kyberpunk/smart_socket/iot_edge_modules/azure-iot-sdk-c/c-utility/devdoc/img/tlsio_state_diagram.png

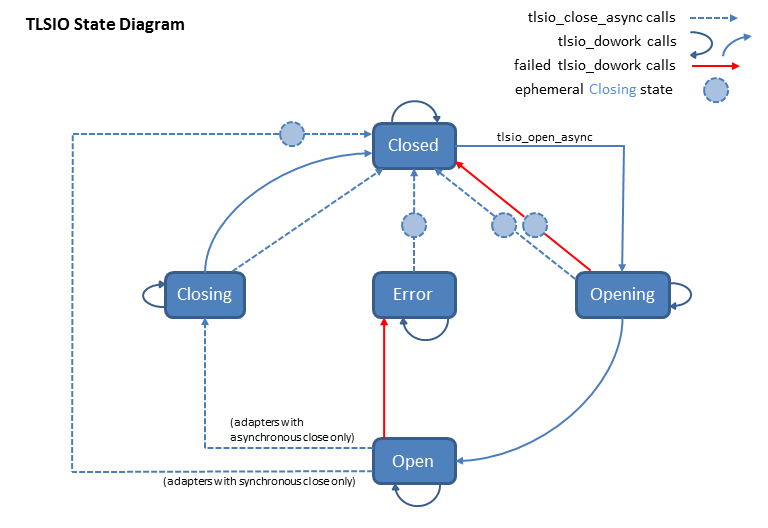
iot_edge_modules/azure-iot-sdk-c/c-utility/devdoc/img/tlsio_state_diagram.png
