kyberpunk/smart_socket/iot_edge_modules/azure-iot-sdk-c/doc/media/azure_portal/azure-portal-eventhub-constring.png

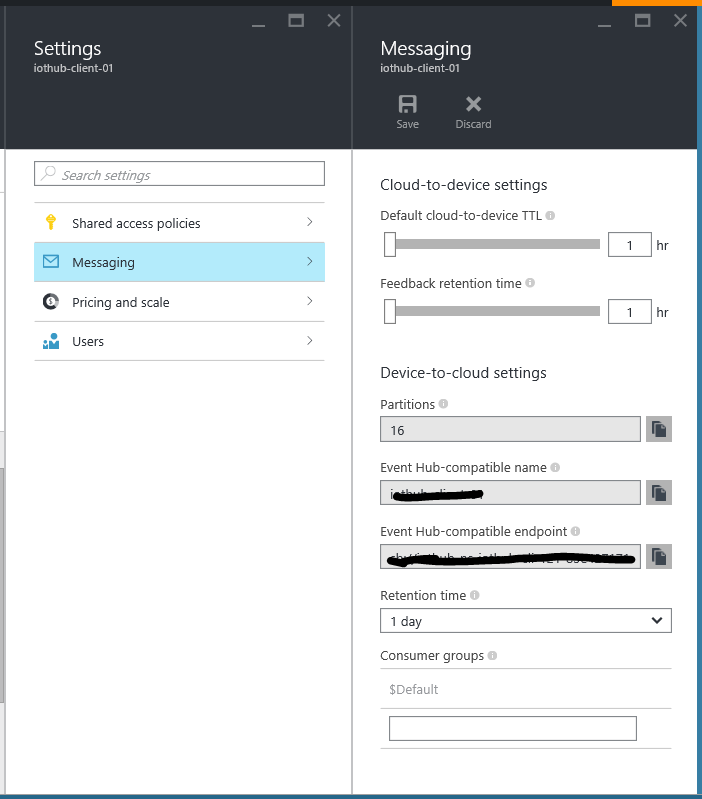
iot_edge_modules/azure-iot-sdk-c/doc/media/azure_portal/azure-portal-eventhub-constring.png
