kyberpunk/smart_socket/iot_edge_modules/azure-iot-sdk-c/doc/media/iothubclient_app_from_scratch/eclipselibraries.png

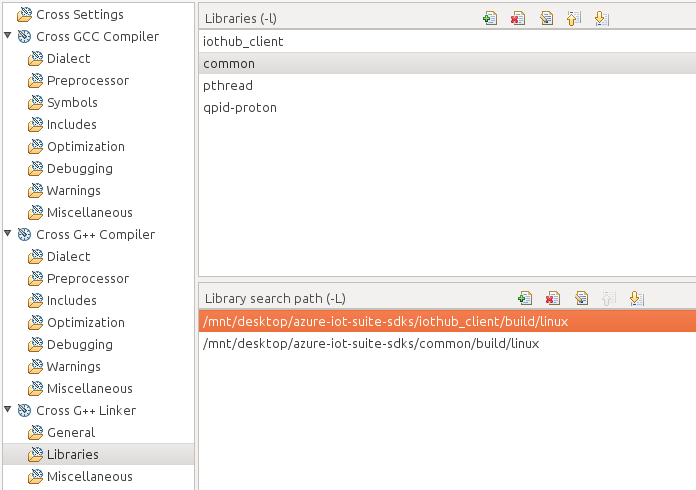
iot_edge_modules/azure-iot-sdk-c/doc/media/iothubclient_app_from_scratch/eclipselibraries.png
