kyberpunk/smart_socket/iot_edge_modules/azure-iot-sdk-c/doc/media/iothubclient_app_from_scratch/vsgenerallinkerproperties.png

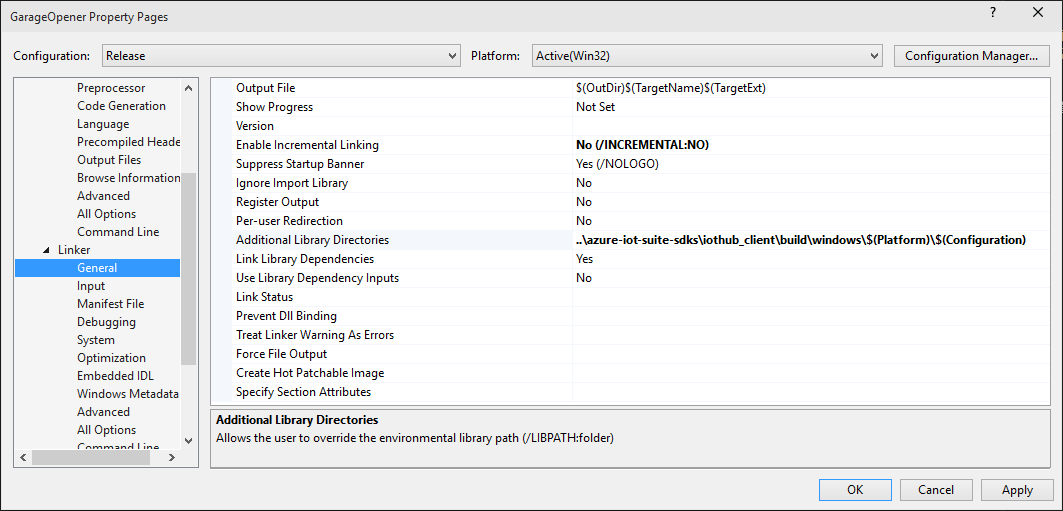
iot_edge_modules/azure-iot-sdk-c/doc/media/iothubclient_app_from_scratch/vsgenerallinkerproperties.png
