kyberpunk/smart_socket/iot_edge_modules/azure-iot-sdk-c/doc/media/tizenRT2.png

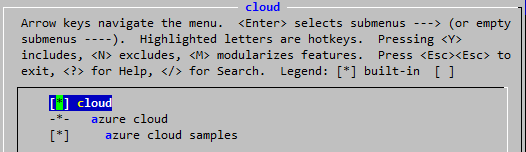
iot_edge_modules/azure-iot-sdk-c/doc/media/tizenRT2.png
