kyberpunk/smart_socket/iot_edge_modules/azure-iot-sdk-c/iothub_client/devdoc/requirement_docs/iothubhttptransport_image.jpg

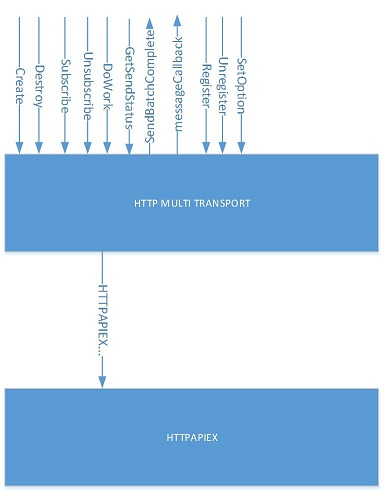
iot_edge_modules/azure-iot-sdk-c/iothub_client/devdoc/requirement_docs/iothubhttptransport_image.jpg
