kyberpunk/smart_socket/iot_edge_modules/azure-iot-sdk-c/lts_branches.png

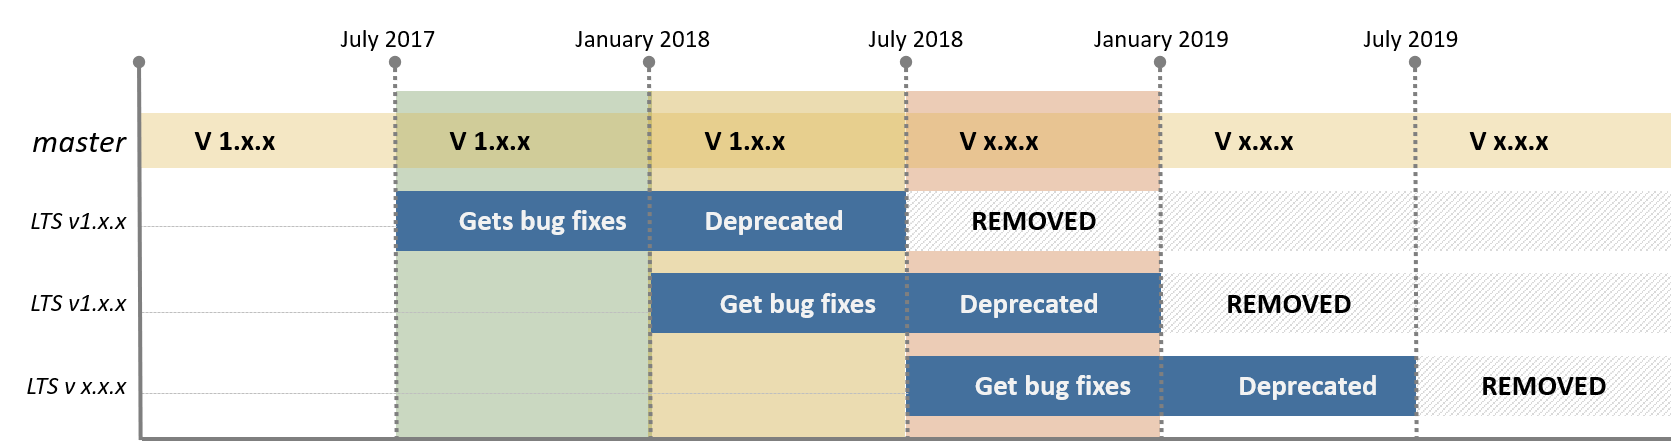
iot_edge_modules/azure-iot-sdk-c/lts_branches.png
