kyberpunk/smart_socket/iot_edge_modules/azure-iot-sdk-c/provisioning_client/devdoc/media/client_high_level_diagram.png

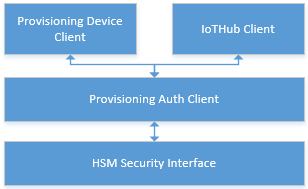
iot_edge_modules/azure-iot-sdk-c/provisioning_client/devdoc/media/client_high_level_diagram.png
