kyberpunk/smart_socket/smart_socket/openthread/doc/images/ot-contrib-qorvo.png

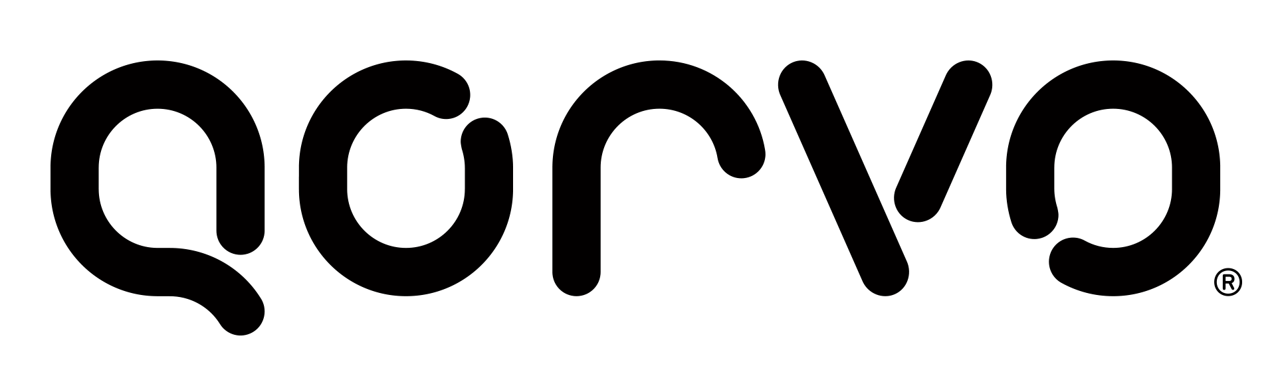
smart_socket/openthread/doc/images/ot-contrib-qorvo.png
