kyberpunk/smart_socket/smart_socket/openthread/doc/images/windows-app-details.png

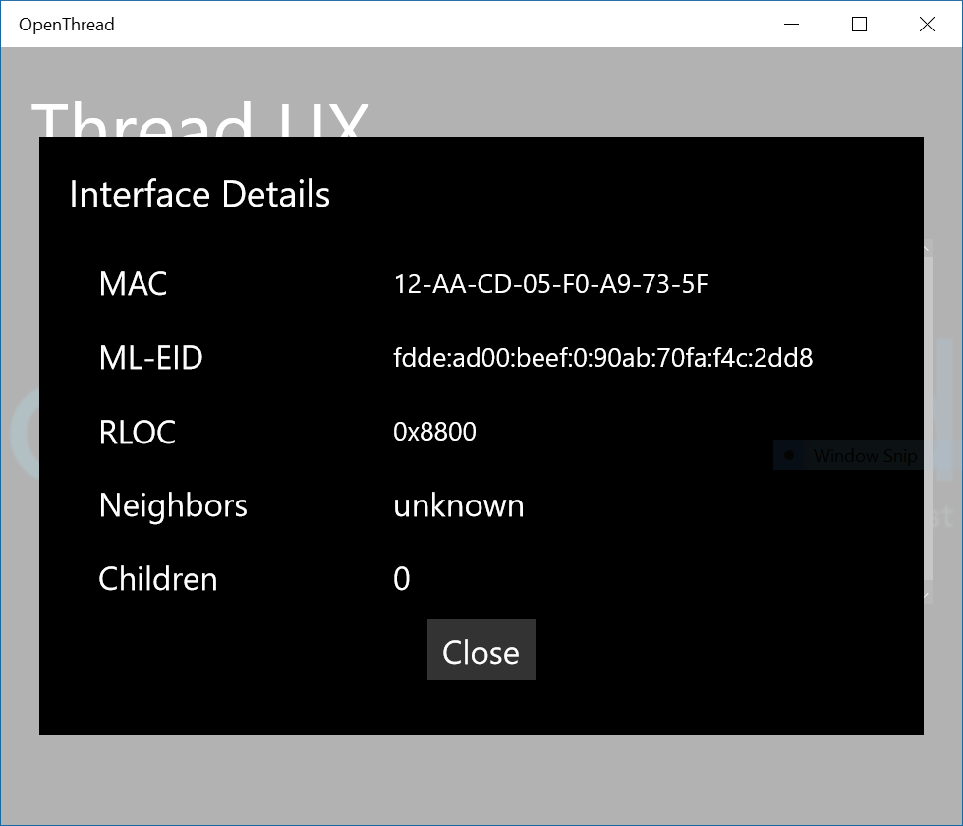
smart_socket/openthread/doc/images/windows-app-details.png
