kyberpunk/smart_socket/smart_socket/openthread/doc/images/windows-app-interface-list.png

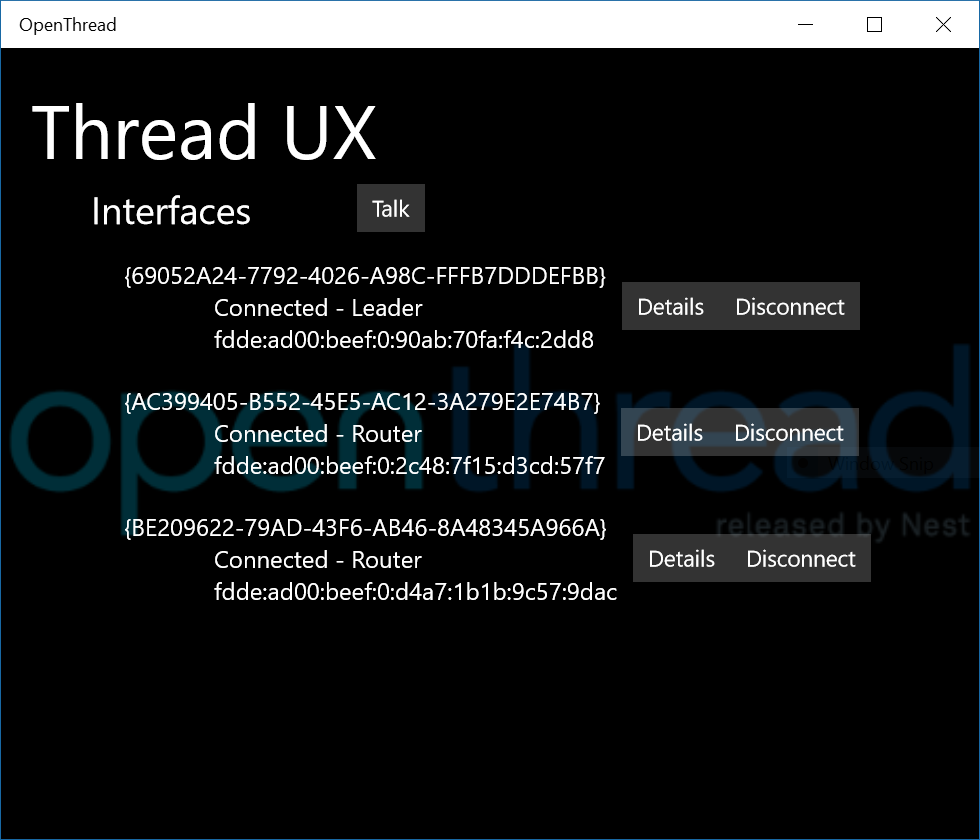
smart_socket/openthread/doc/images/windows-app-interface-list.png
