kyberpunk/smart_socket/smart_socket/openthread/doc/images/windows-app-talk-client.png

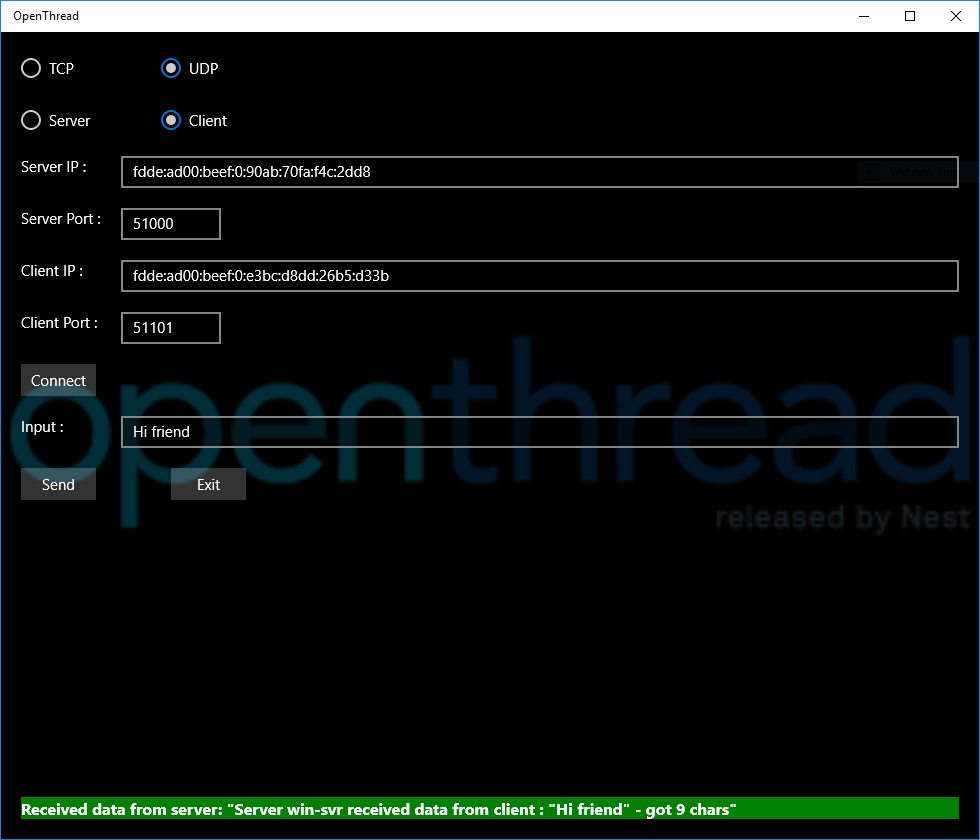
smart_socket/openthread/doc/images/windows-app-talk-client.png
