kyberpunk/smart_socket/smart_socket/openthread/doc/images/windows-app-talk-server.png

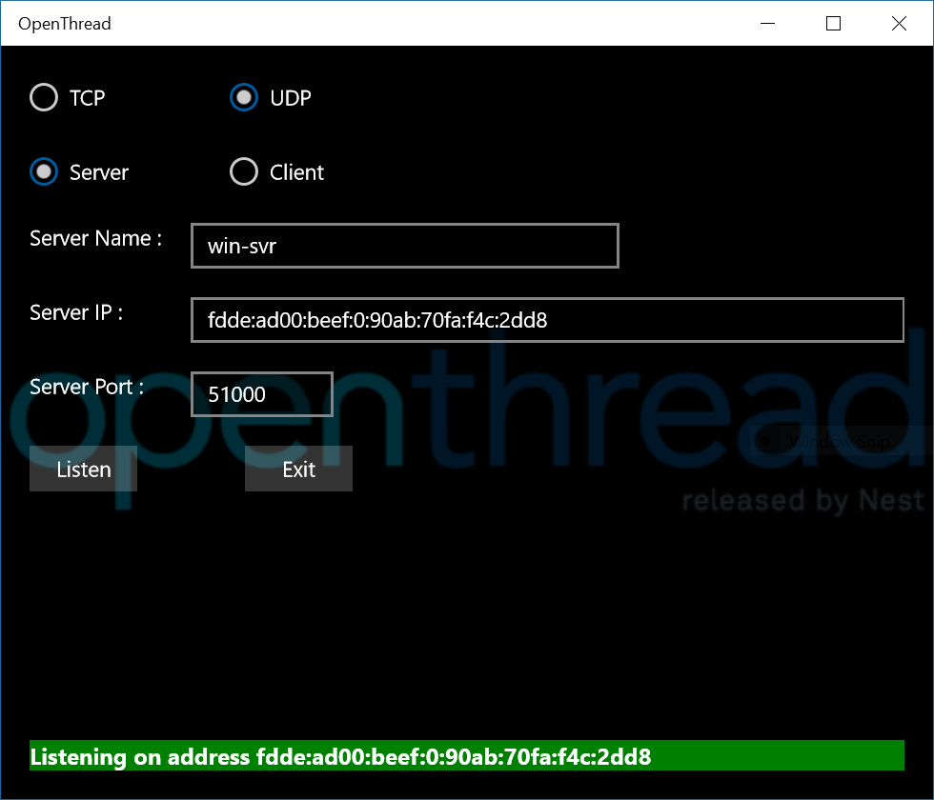
smart_socket/openthread/doc/images/windows-app-talk-server.png
