kyberpunk/smart_socket/smart_socket/openthread/doc/images/windows_design.png

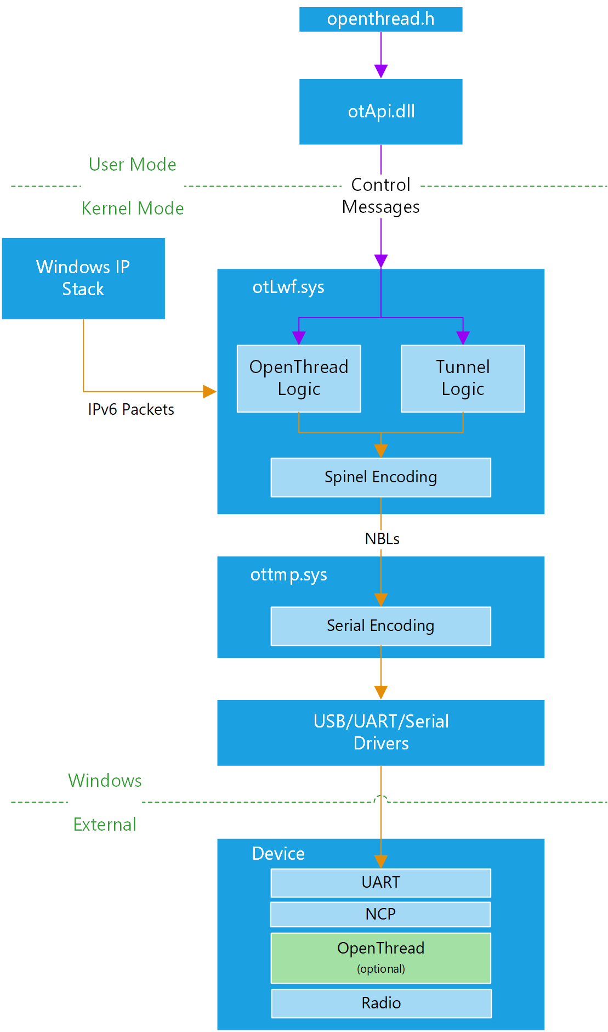
smart_socket/openthread/doc/images/windows_design.png
