kyberpunk/smart_socket/smart_socket/openthread/tools/harness-thci/OpenThread.png

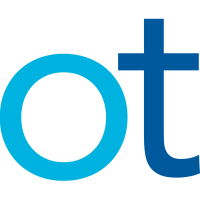
smart_socket/openthread/tools/harness-thci/OpenThread.png
