kyberpunk/smart_socket/iot_edge_modules/azure-iot-sdk-c/doc/media/service-bus-iot-raspberrypi-raspbian-setup/raspbian01.png

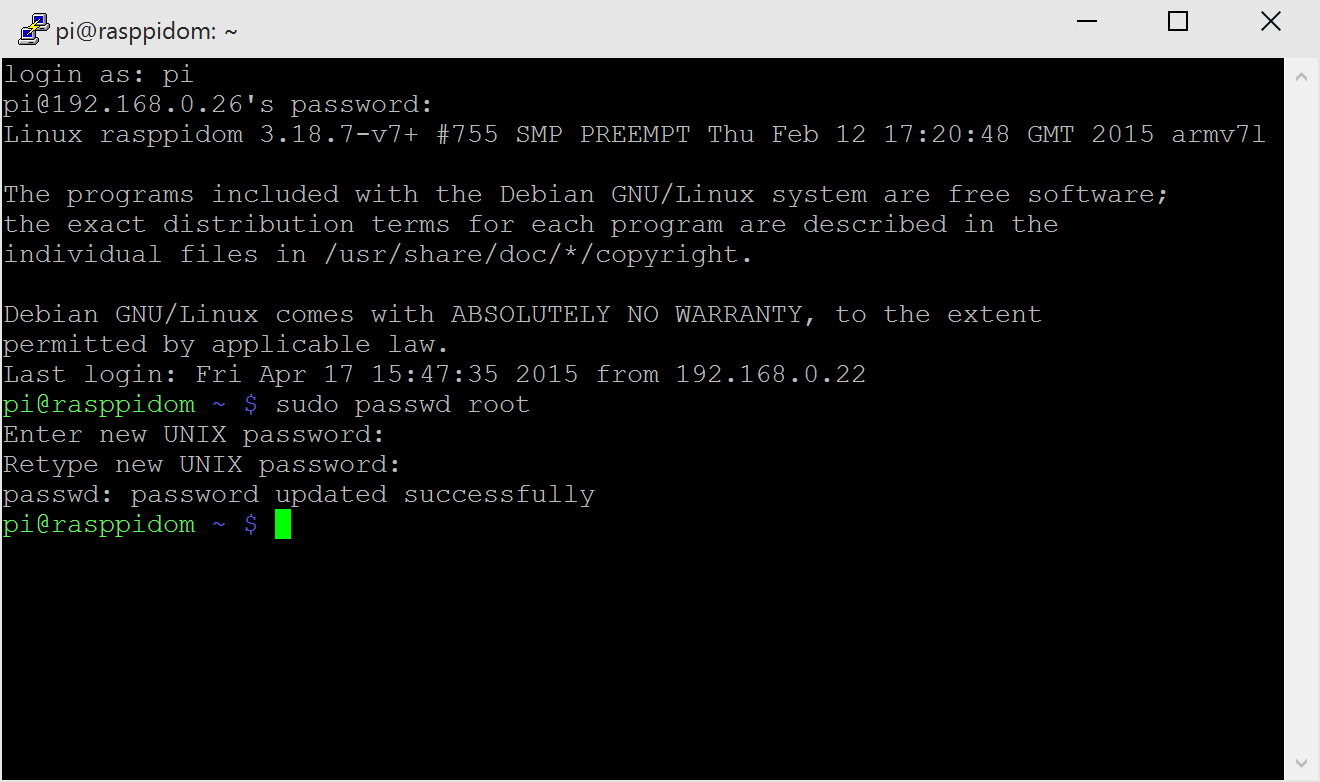
iot_edge_modules/azure-iot-sdk-c/doc/media/service-bus-iot-raspberrypi-raspbian-setup/raspbian01.png
