kyberpunk/smart_socket/docs/chip_shield_sch.pdf

10k ⁺³V3 | GND | +³V3

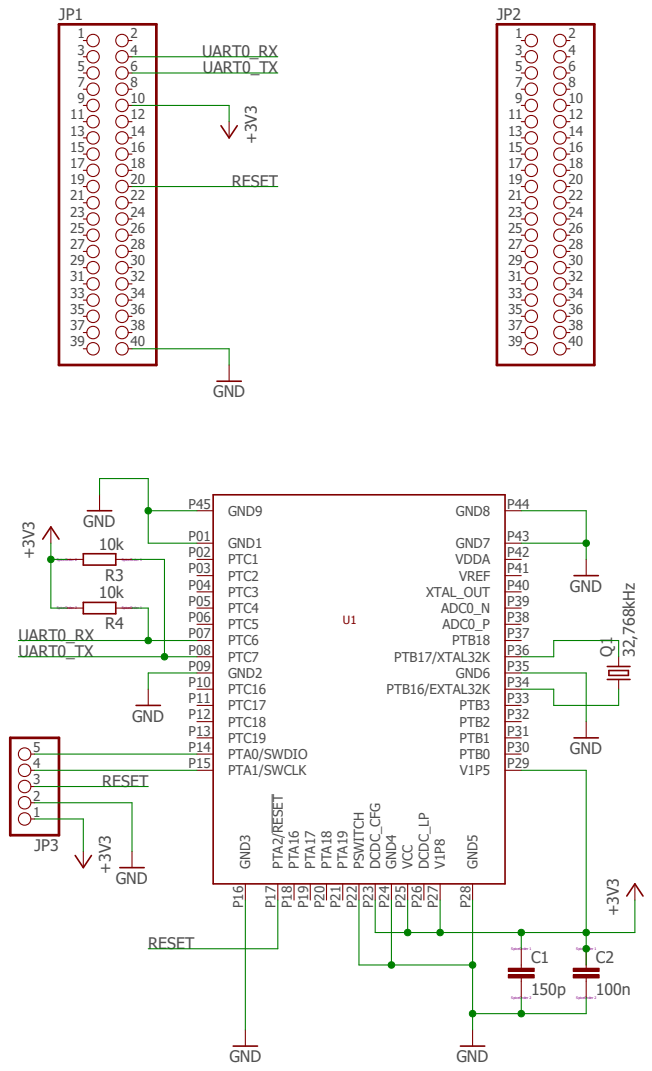
[picture p54: page 1]

Document Number: Author: Vít Holásek | REV:

Date: 16.05.2018 22:05 | Sheet: 1/1
