kyberpunk/smart_socket/docs/smart_socket_sch.pdf

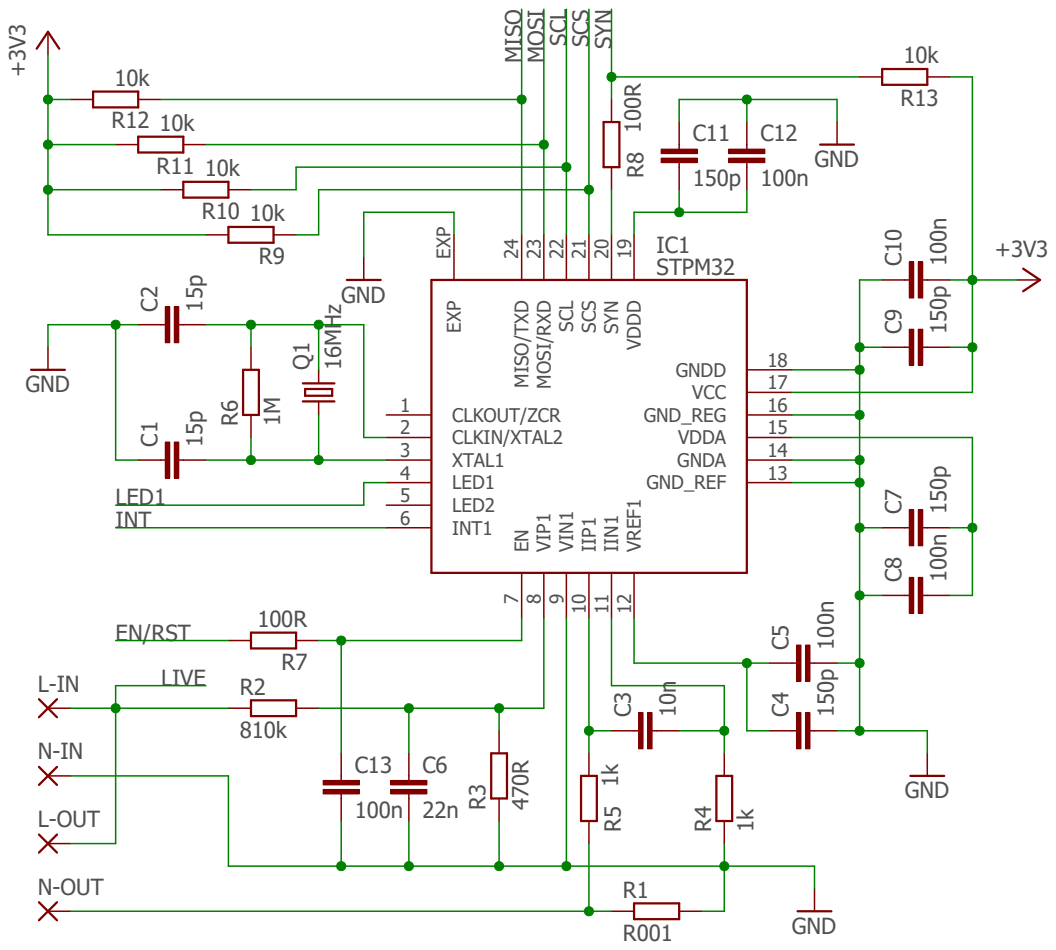
[picture p55: page 1]

Document Number: Author: Vít Holásek | REV:

Date: 14.05.2018 21:31 | Sheet: 1/2

# GND ⁺³V3 32,768kHz

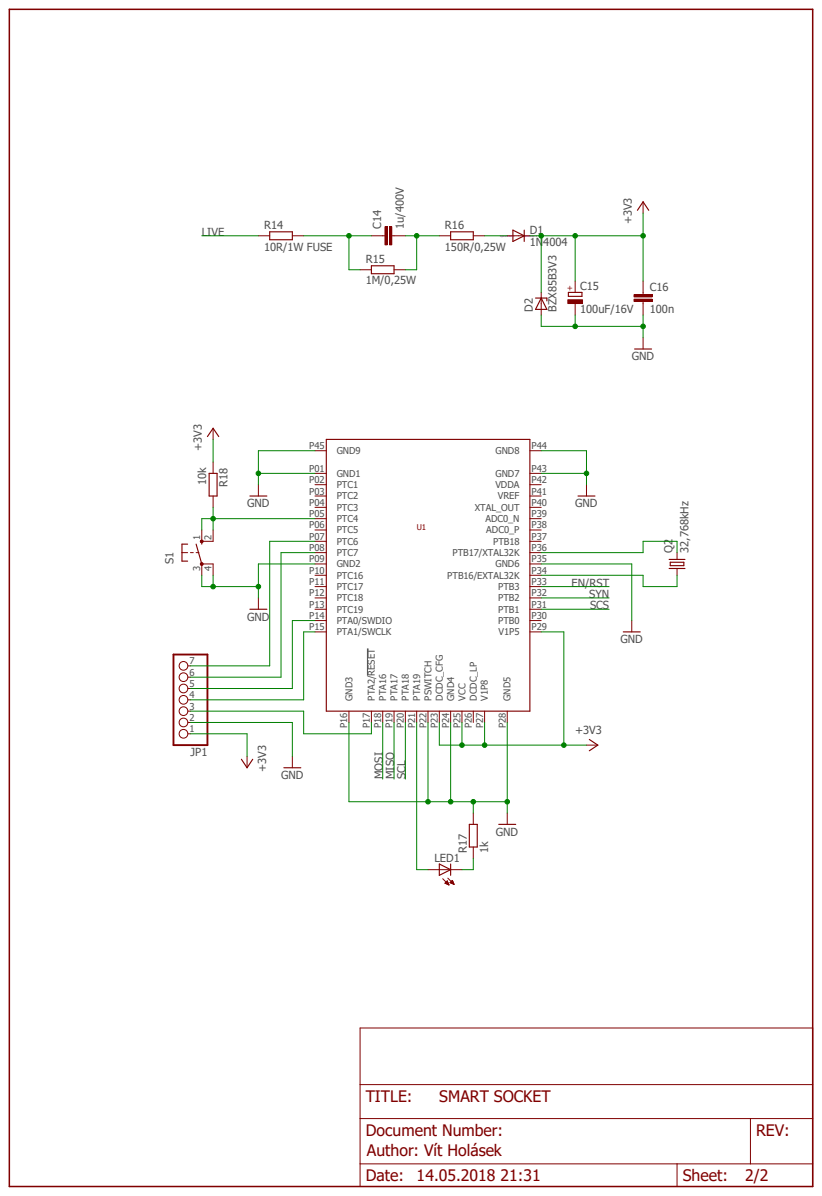
[picture p56: page 2]

SYN MOSI MISO SCL

Document Number: Author: Vít Holásek | REV:

Date: 14.05.2018 21:31 | Sheet: 2/2
