kyberpunk/smart_socket/docs/eagle/CHIP SHIELD.sch

## EAGLE design docs/eagle/CHIP SHIELD.sch (2018-07-29)

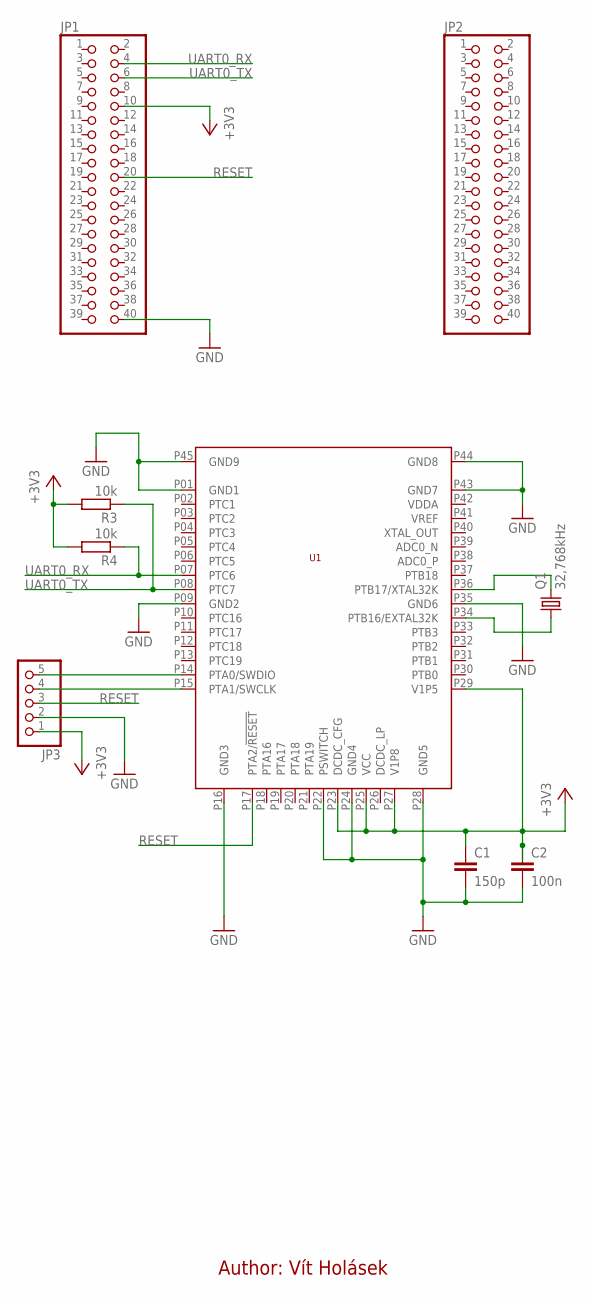
[picture p57: schematic CHIP SHIELD.sch]

Parts:
C1: 150p; C0402
C2: 100n; C0402
JP1, JP2: PINHD-2X20; 2X20
JP3: PINHD-1X5; 1X05
Q1: 32,768kHz; MC-306
R3, R4: 10k; R0402
U1: R41Z-T; R41Z

Connections:
+3V3: C1.1, C2.1, JP1.10, JP3.1, R3.2, R4.2, U1.P23 (DCDC_CFG), U1.P25 (VCC), U1.P27 (V1P8), U1.P29 (V1P5)
GND: C1.2, C2.2, JP1.40, JP3.2, U1.P01 (GND1), U1.P09 (GND2), U1.P16 (GND3), U1.P22 (PSWITCH), U1.P24 (GND4), U1.P28 (GND5), U1.P35 (GND6), U1.P43 (GND7), U1.P44 (GND8), U1.P45 (GND9)
unnamed: Q1.1, U1.P34 (PTB16/EXTAL32K)
unnamed: Q1.4 (2), U1.P36 (PTB17/XTAL32K)
unnamed: JP3.4, U1.P15 (PTA1/SWCLK)
unnamed: JP3.5, U1.P14 (PTA0/SWDIO)
RESET: JP1.20, JP3.3, U1.P17 (PTA2/!RESET!)
UART0_RX: JP1.4, R4.1, U1.P07 (PTC6)
UART0_TX: JP1.6, R3.1, U1.P08 (PTC7)

Notes on the sheet:
Author: Vít Holásek
