kyberpunk/smart_socket/docs/eagle/SMART SOCKET.sch

## EAGLE design docs/eagle/SMART SOCKET.sch (2018-07-29)

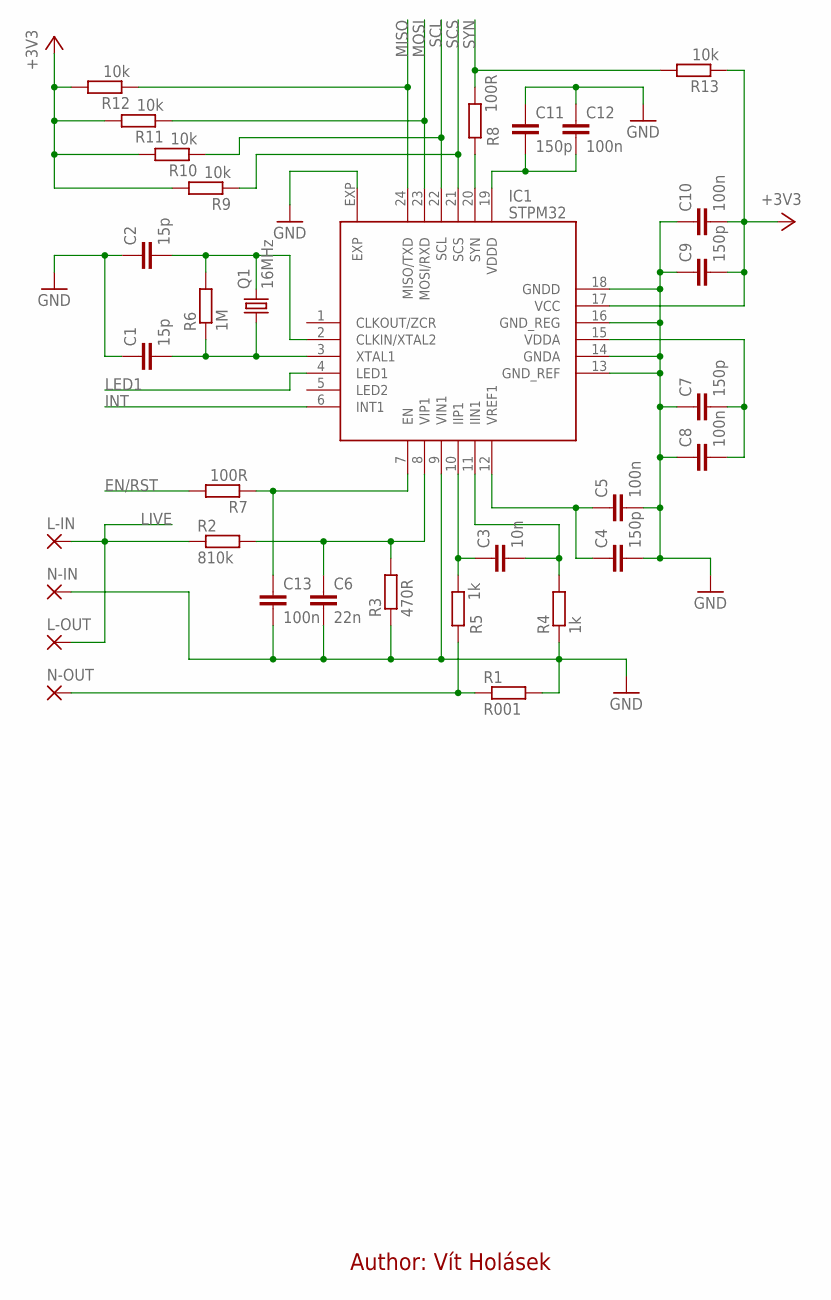
[picture p58: schematic SMART SOCKET.sch, sheet 1]

Parts:
C1, C2: 15p; C0402
C3: 10n; C0402
C4, C7, C9, C11: 150p; C0402
C5, C8, C10, C12: 100n; C0402
C6: 22n; C0603
C13: 100n; C0603
IC1: STPM32; QFN24L
L-IN: 2,54/1,1
L-OUT: 2,54/1,1
N-IN: 2,54/1,1
N-OUT: 2,54/1,1
Q1: 16MHz; CTS406
R1: R001; R2512
R2: 810k; R0603
R3: 470R; R0603
R4, R5: 1k; R0402
R6: 1M; R0402
R7, R8: 100R; R0402
R9, R10, R11, R12, R13: 10k; R0402

Connections:
+3V3: C9.2, C10.2, IC1.17 (VCC), R9.2, R10.2, R11.2, R12.2, R13.1
EN/RST: R7.2
GND: C1.1, C2.1, C4.2, C5.2, C6.2, C7.1, C8.1, C9.1, C10.1, C11.1, C12.1, C13.2, IC1.9 (VIN1), IC1.13 (GND_REF), IC1.14 (GNDA), IC1.16 (GND_REG), IC1.18 (GNDD), IC1.EXP, N-IN.1, R1.2, R3.1, R4.1
INT: IC1.6 (INT1)
LED1: IC1.4 (LED1)
LIVE: L-IN.1, L-OUT.1, R2.1
MISO: IC1.24 (MISO/TXD), R12.1
MOSI: IC1.23 (MOSI/RXD), R11.1
unnamed: C2.2, IC1.2 (CLKIN/XTAL2), Q1.3 (2), R6.2
unnamed: C4.1, C5.1, IC1.12 (VREF1)
unnamed: C1.2, IC1.3 (XTAL1), Q1.1, R6.1
unnamed: C6.1, IC1.8 (VIP1), R2.2, R3.2
unnamed: N-OUT.1, R1.1, R5.1
unnamed: C3.1, IC1.10 (IIP1), R5.2
unnamed: C3.2, IC1.11 (IIN1), R4.2
unnamed: IC1.20 (SYN), R8.1
unnamed: C13.1, IC1.7 (EN), R7.1
unnamed: C7.2, C8.2, IC1.15 (VDDA)
unnamed: C11.2, C12.2, IC1.19 (VDDD)
SCL: IC1.22 (SCL), R10.1
SCS: IC1.21 (SCS), R9.1
SYN: R8.2, R13.2

Notes on the sheet:
Author: Vít Holásek

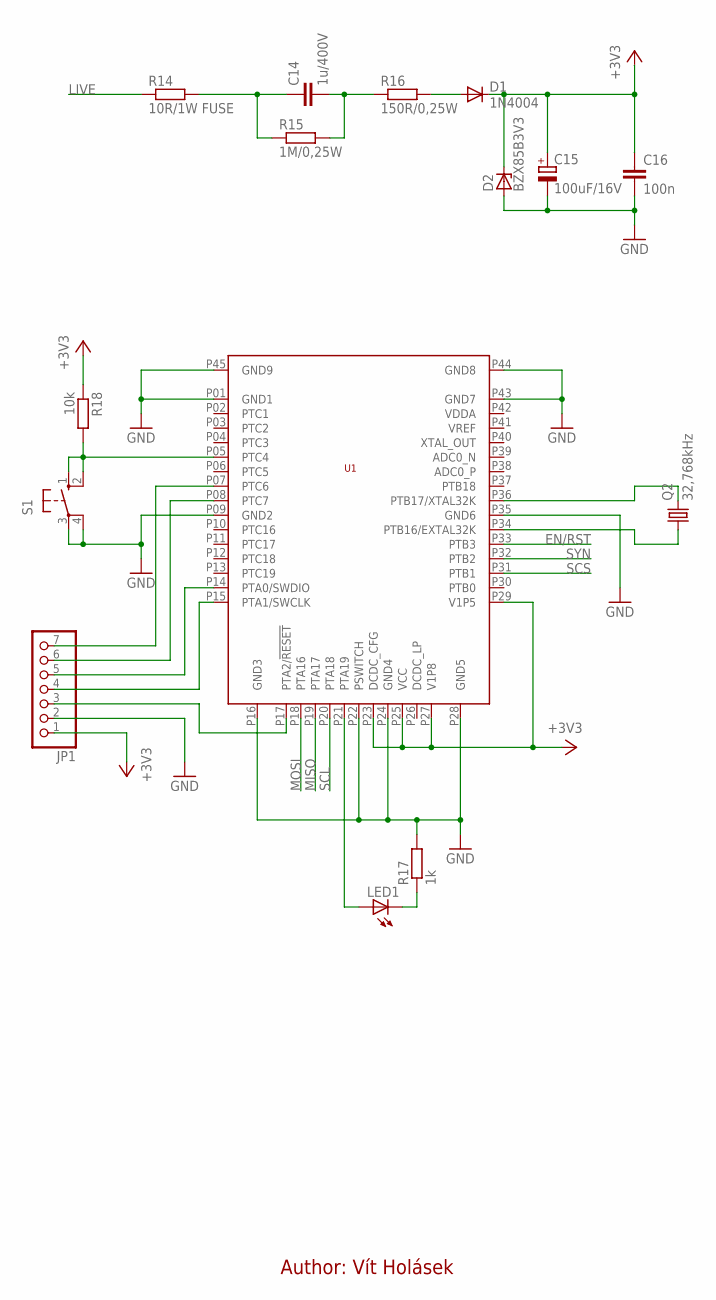
[picture p59: schematic SMART SOCKET.sch, sheet 2]

Parts:
C14: 1u/400V; C0805
C15: 100uF/16V; E5-8,5
C16: 100n; C0603
D1: 1N4004; DO41-10
D2: BZX85B3V3; DO41Z10
JP1: PINHD-1X7; 1X07
LED1: LED3MM
Q2: 32,768kHz; TC26V
R14: 10R/1W FUSE; 0204/7
R15: 1M/0,25W; R0805
R16: 150R/0,25W; R0805
R17: 1k; R0402
R18: 10k; R0402
S1: 10-XX; B3F-10XX
U1: R41Z-T; R41Z

Connections:
+3V3: C15.+, C16.1, D1.C, D2.C, JP1.1, R18.1, U1.P23 (DCDC_CFG), U1.P25 (VCC), U1.P27 (V1P8), U1.P29 (V1P5)
EN/RST: U1.P33 (PTB3)
GND: C15.-, C16.2, D2.A, JP1.2, R17.2, S1.3, S1.4 (P1), U1.P01 (GND1), U1.P09 (GND2), U1.P16 (GND3), U1.P22 (PSWITCH), U1.P24 (GND4), U1.P28 (GND5), U1.P35 (GND6), U1.P43 (GND7), U1.P44 (GND8), U1.P45 (GND9)
LIVE: R14.1
MISO: U1.P19 (PTA17)
MOSI: U1.P18 (PTA16)
unnamed: C14.2, R15.2, R16.1
unnamed: C14.1, R14.2, R15.1
unnamed: D1.A, R16.2
unnamed: Q2.2, U1.P36 (PTB17/XTAL32K)
unnamed: Q2.1, U1.P34 (PTB16/EXTAL32K)
unnamed: LED1.A, U1.P21 (PTA19)
unnamed: LED1.K (C), R17.1
unnamed: R18.2, S1.1 (S), S1.2 (S1), U1.P05 (PTC4)
unnamed: JP1.7, U1.P07 (PTC6)
unnamed: JP1.6, U1.P08 (PTC7)
unnamed: JP1.5, U1.P14 (PTA0/SWDIO)
unnamed: JP1.4, U1.P15 (PTA1/SWCLK)
unnamed: JP1.3, U1.P17 (PTA2/!RESET!)
SCL: U1.P20 (PTA18)
SCS: U1.P31 (PTB1)
SYN: U1.P32 (PTB2)

Notes on the sheet:
Author: Vít Holásek
