kyberpunk/smart_socket/smart_socket/metrology/drivers/src/metrology_hal.c

/**
  ******************************************************************************
  * @file    metrology_hal.c
  * @author  STMicroelectronics
  * @version V1.0
  * @date    17 May 2016
  * @brief   This file provides The hardware abstraction for Metrology Block.
  * @brief
  ******************************************************************************
  * @attention
  *
  * THE PRESENT FIRMWARE WHICH IS FOR GUIDANCE ONLY AIMS AT PROVIDING CUSTOMERS
  * WITH CODING INFORMATION REGARDING THEIR PRODUCTS IN ORDER FOR THEM TO SAVE
  * TIME. AS A RESULT, STMICROELECTRONICS SHALL NOT BE HELD LIABLE FOR ANY
  * DIRECT, INDIRECT OR CONSEQUENTIAL DAMAGES WITH RESPECT TO ANY CLAIMS ARISING
  * FROM THE CONTENT OF SUCH FIRMWARE AND/OR THE USE MADE BY CUSTOMERS OF THE
  * CODING INFORMATION CONTAINED HEREIN IN CONNECTION WITH THEIR PRODUCTS.
  *
  * <h2><center>&copy; COPYRIGHT 2014 STMicroelectronics</center></h2>
  ******************************************************************************
  */

/* Includes ------------------------------------------------------------------*/

#include "stpm_metrology.h"
#include "metrology.h"
#include "metrology_hal.h"
#include <string.h>
#include <stdint.h>
#include "st_device.h"
#include "metrology_platform.h"

/* Private typedef -----------------------------------------------------------*/
/* Private define ------------------------------------------------------------*/

#define METRO_BUFF_COM_MAXSIZE  ((uint8_t)(40))

#define CRC_8 (0x07)
#define STPM3x_FRAME_LEN (5)

#define WAIT_DURATION   500   /* 500 * 1 ms = 500 ms */

#ifdef  USE_FULL_ASSERT

/**
  * @brief  The assert_param macro is used for function's parameters check.
  * @param  expr If expr is false, it calls assert_failed function
  *   which reports the name of the source file and the source
  *   line number of the call that failed.
  *   If expr is true, it returns no value.
  * @retval None
  */
  #define assert_param(expr) ((expr) ? (void)0 : assert_failed((uint8_t *)__FILE__, __LINE__))
/* Exported functions ------------------------------------------------------- */
  void assert_failed(uint8_t* file, uint32_t line);
#else
  #define assert_param(expr) ((void)0)
#endif /* USE_FULL_ASSERT */

/* Private macro -------------------------------------------------------------*/
/* Private variables ---------------------------------------------------------*/

static uint8_t CRC_u8Checksum;

/* Private function prototypes -----------------------------------------------*/
#ifdef UART_XFER_STPM3X /* UART MODE */  
//static void Metro_HAL_usart_config(METRO_NB_Device_t in_Metro_Device_Id,uint32_t in_baudrate);
static void Metro_HAL_UsartTxStart(METRO_NB_Device_t in_Metro_Device_Id);
static uint8_t UARTWrp_SendAndReceiveByte(METRO_NB_Device_t in_Metro_Device_Id,uint8_t data);
static uint8_t Metro_HAL_byteReverse(uint8_t in_byte);
#endif

static void Metro_HAL_Crc8Calc (uint8_t in_Data);
static uint8_t Metro_HAL_CalcCRC8(uint8_t *pBuf);
static void Metro_HAL_WaitMicroSecond(uint32_t time);
static void Metro_HAL_reset_transfer_context(METRO_NB_Device_t in_Metro_Device_Id);
static void Metro_HAL_STPM_SYN_reset_3_pulses(METRO_NB_Device_t in_Metro_Device_Id);
static void Metro_HAL_STPM_SYN_single_pulse(METRO_NB_Device_t in_Metro_Device_Id);
static void Metro_HAL_CSS_EXT_Device(METRO_NB_Device_t in_Metro_Device_Id,MET_GPIO_PIN_State_t in_Metro_enable);
static void Metro_HAL_EN_EXT_Device(METRO_NB_Device_t in_Metro_Device_Id,MET_GPIO_PIN_State_t in_Metro_enable);
static void Metro_HAL_SYN_EXT_Device(METRO_NB_Device_t in_Metro_Device_Id,MET_GPIO_PIN_State_t in_Metro_enable);


static void Metro_HAL_RxHandler(METRO_NB_Device_t in_Metro_Device_Id);
static void Metro_HAL_TxHandler(METRO_NB_Device_t in_Metro_Device_Id);

#ifdef SPI_XFER_STPM3X /* SPI MODE */ 
//static void Metro_HAL_Spi_config(METRO_NB_Device_t in_Metro_Device_Id);
static void Metro_HAL_SpiTxStart(METRO_NB_Device_t in_Metro_Device_Id);
static uint8_t SPIWrp_SendAndReceiveByte(METRO_NB_Device_t in_Metro_Device_Id,uint8_t data);
#endif


/* Global variables ----------------------------------------------------------*/

METRO_Device_Config_t * p_Metro_Device_Config;
uint8_t Metro_Com_TxBuf[METRO_BUFF_COM_MAXSIZE];
uint8_t Metro_Com_RxBuf[METRO_BUFF_COM_MAXSIZE];

/* Private functions ---------------------------------------------------------*/

/** @defgroup Metrology_HAL_Private_Functions
* @{
*/

/** @defgroup Metrology_Group1 Initialization and Configuration functions
*  @brief   Initialization and Configuration functions
*
@verbatim
===============================================================================
                functions
===============================================================================

This section provides a set of functions to make the porting of Metrology Block from STCOMET or STMET or STPM

@endverbatim
* @{
*/


/**
  * @brief  HAL  metrology Config
  *
  *
  * @retval U32
  */
/* set metrology HAL Config  */
uint8_t Metro_HAL_Setup(METRO_Device_Config_t * in_p_Metro_Config)
{
  /* Save the pointer of Config table */
  p_Metro_Device_Config = in_p_Metro_Config;

  return 0;

}


/**
  * @brief  Read Block Registers from device
  *
  *
  * @retval void
  */
uint8_t Metrology_HAL_ReadBlock(METRO_NB_Device_t in_Metro_Device_Id, uint8_t Offset, uint8_t BlockNum, uint32_t * out_p_Buffer)
{
  uint32_t tmp_addr = 0x0;
  uint8_t  error=0;

  if ( in_Metro_Device_Id >= EXT1)// modif
  {
    /* Calculate the base address to read inisde STPM chip  */
    /* the offset should be provided (2 bytes -> 16 bits) format for STPM */
    tmp_addr = (uint32_t)&METRO_STPM->DSPCTRL1 + Offset;

    /* read blocks from external chip */
    Metro_HAL_Stpm_Read(in_Metro_Device_Id,(uint8_t*)&tmp_addr,BlockNum,out_p_Buffer);

  }
  return error;
}
/**
  * @brief  Write Block Registers to device
  *
  *
  * @retval void
  */
uint8_t Metrology_HAL_WriteBlock(METRO_NB_Device_t in_Metro_Device_Id, uint8_t Offset, uint8_t BlockNum, uint32_t * in_p_Buffer)
{
  uint32_t tmp_addr = 0x0;
  uint32_t ret_size = 0;

  if ( in_Metro_Device_Id >= EXT1)// modif
  {
    /* Calculate the base address to read inisde STPM chip  */
    /* the offset should be provided in 2 bytes format (16 bits by 16 bits) for STPM */
    tmp_addr = (uint32_t)&METRO_STPM->DSPCTRL1 + (Offset);

    /* write blocks from external chip */
    ret_size = Metro_HAL_Stpm_write(in_Metro_Device_Id,(uint8_t*)&tmp_addr,BlockNum,in_p_Buffer,STPM_WAIT); 
  }
  return(ret_size);
}


/**
  * @brief  Init Metrology devices
  *
  *
  * @retval void
  */
void Metro_HAL_init_device(METRO_NB_Device_t in_Metro_Device_Id)
{
	metrology_platform_log(MET_LOG_INFO, "Device initialization: %d; %d", in_Metro_Device_Id, p_Metro_Device_Config[in_Metro_Device_Id].device);
  if(in_Metro_Device_Id >= EXT1 && p_Metro_Device_Config[in_Metro_Device_Id].device != Device_NONE)
  {

#ifdef UART_XFER_STPM3X // UART MODE
	  metrology_platform_log(MET_LOG_INFO, "Metro_HAL_usart_config 9600");
    Metro_HAL_usart_config(in_Metro_Device_Id,9600); 
#endif    

#ifdef SPI_XFER_STPM3X // SPI mode
    Metro_HAL_Spi_config(in_Metro_Device_Id);
#endif 

    /* set good CS with good EXT chip */
    Metro_HAL_CSS_EXT_Device(in_Metro_Device_Id,MET_GPIO_PIN_SET);
    Metro_HAL_WaitMicroSecond(1000);
  
    /* Reset EXT Chip */
    /* 3 pulses on SYN */
    Metro_HAL_STPM_SYN_reset_3_pulses(in_Metro_Device_Id);
           
    /* Single pulse on CS rev BC */        
    Metro_HAL_WaitMicroSecond(1000); 
    Metro_HAL_CSS_EXT_Device(in_Metro_Device_Id,MET_GPIO_PIN_RESET);
    Metro_HAL_WaitMicroSecond(100); 
    Metro_HAL_CSS_EXT_Device(in_Metro_Device_Id,MET_GPIO_PIN_SET);
      
   /* Wait 20 ms */
   Metro_HAL_WaitMicroSecond(40000);
   
   /* Make one access ( first reg u32 reg) to ext chip to check if it is available */
   
   metrology_platform_log(MET_LOG_INFO, "Metro_HAL_Stpm_Read...");
   uint32_t addr = 0;
   if (Metro_HAL_Stpm_Read(in_Metro_Device_Id,(uint8_t*)&addr,1,&p_Metro_Device_Config[in_Metro_Device_Id].metro_stpm_reg.DSPCTRL1)<=0)
   {
	   metrology_platform_log(MET_LOG_WARN, "Device set to none");
    // Reset Config for EXT chip 
    p_Metro_Device_Config[in_Metro_Device_Id].device   = Device_NONE;
    p_Metro_Device_Config[in_Metro_Device_Id].channels_mask = 0;

   }
  }
}

/**
  * @brief  Enable Metrology devices by setting up and down the EN pin
  *         When EN is low the CSS is set low or high depending of the 
  *         protocol used (SPI or UART)
  * @retval void
  */

void Metro_HAL_power_up_device(METRO_NB_Device_t in_Metro_Device_Id)
{
  if(in_Metro_Device_Id >= EXT1) 
  {
  
#ifdef UART_XFER_STPM3X /* UART MODE */   
    /* set UART mode at STPM3x power up, we have to set SS pin */
    Metro_HAL_CSS_EXT_Device(in_Metro_Device_Id,MET_GPIO_PIN_SET);
#endif

#ifdef SPI_XFER_STPM3X /* SPI MODE */   
    /* set SPI mode at STPM3x power up, we have to reset SS pin */
    Metro_HAL_CSS_EXT_Device(in_Metro_Device_Id,MET_GPIO_PIN_RESET); 
#endif

    /* set ENable Pin configured as low in CubeMX*/
    Metro_HAL_WaitMicroSecond(1000); 
    Metro_HAL_EN_EXT_Device(in_Metro_Device_Id,MET_GPIO_PIN_RESET);
    Metro_HAL_WaitMicroSecond(1000); 
    Metro_HAL_EN_EXT_Device(in_Metro_Device_Id,MET_GPIO_PIN_SET);
    Metro_HAL_WaitMicroSecond(1000); 
  }
}

/**
  * @brief      This function reset device requested
  * @param[in]   in_Metro_Device_Id (device ID), EXT1 to EXT4
  * @param[in]   Reset type
  * @param[out]  none
  * @retval
  */
void Metro_HAL_reset_device(METRO_ResetType_t in_MetroResetType,METRO_NB_Device_t in_Metro_Device_Id)
{
  uint32_t tmp_addr = 0;

  if(in_Metro_Device_Id >= EXT1) 
  {
    if (in_MetroResetType ==  RESET_SW)
    {
      /* Set the reset bit in the  DSP Control Register 3 of stpm requested(STPM) */
      /* First put the bit inside internal struct */
      p_Metro_Device_Config[in_Metro_Device_Id].metro_stpm_reg.DSPCTRL3 |= METRO_STPM_Reset_Bit;

      /* second : write into external the chip */
        /* Calculate the base address to read inisde STPM chip  */
        /* the offset should be provided in 2 bytes format (16 bits by 16 bits) for STPM */
      tmp_addr = (uint32_t)((uint8_t*)&p_Metro_Device_Config[in_Metro_Device_Id].metro_stpm_reg.DSPCTRL3 - (uint8_t*)&p_Metro_Device_Config[in_Metro_Device_Id].metro_stpm_reg.DSPCTRL1)/2;

     /* Write blocks inside external chip */
      Metro_HAL_Stpm_write(in_Metro_Device_Id,(uint8_t*)&tmp_addr,1,&p_Metro_Device_Config[in_Metro_Device_Id].metro_stpm_reg.DSPCTRL3,STPM_WAIT);


    }
    /* reset SYN hardware is requested, send 3 pulses to SYN signal pin */
    else if (in_MetroResetType ==  RESET_SYN_SCS)
    {
      /* Reset ext STPMs with syn PIN : 3 pulses are needed to reset STPM chips */
      Metro_HAL_STPM_SYN_reset_3_pulses(in_Metro_Device_Id);
    }
  }
}

/**
  * @brief      This function set latch inside Metrology devices
               Latch the device registers according to the latch type selection driving SYN pin
               or writing S/W Latchx bits in the DSP_CR3 register
               or setting auto-latch by S/W Auto Latch bit in the DSP_CR3 register
  * @param[in]   in_Metro_Device_Id (device ID), EXT1 to EXT4
  * @param[in]   Latch type
  * @param[out]  none
  * @retval
  */
void Metro_HAL_Set_Latch_device_type(METRO_NB_Device_t in_Metro_Device_Id, METRO_Latch_Device_Type_t in_Metro_Latch_Device_Type)
{
  uint32_t tmp_addr = 0;

  if(in_Metro_Device_Id >= EXT1) 
  {
    switch (in_Metro_Latch_Device_Type)
    {

      case LATCH_AUTO:
      {

        /* reset latch 1 and 2 bits in the internal DSP Control Register 3 */
        p_Metro_Device_Config[in_Metro_Device_Id].metro_stpm_reg.DSPCTRL3 &= ~ BIT_MASK_STPM_LATCH1;
        p_Metro_Device_Config[in_Metro_Device_Id].metro_stpm_reg.DSPCTRL3 &= ~ BIT_MASK_STPM_LATCH2;


        /* Set  latch auto in the internal DSP Control Register 3*/
        p_Metro_Device_Config[in_Metro_Device_Id].metro_stpm_reg.DSPCTRL3 |= BIT_MASK_STPM_AUTO_LATCH;

        /* Now send data to the external chip */
        /* Calculate the base address to read inisde STPM chip  */
        /* the offset should be provided in 2 bytes format (16 bits by 16 bits) for STPM */
        tmp_addr = (uint32_t)((uint8_t*)&p_Metro_Device_Config[in_Metro_Device_Id].metro_stpm_reg.DSPCTRL3 - (uint8_t*)&p_Metro_Device_Config[in_Metro_Device_Id].metro_stpm_reg.DSPCTRL1)/2;

        /* Write register inside external chip */
        Metro_HAL_Stpm_write(in_Metro_Device_Id,(uint8_t*)&tmp_addr,1,&p_Metro_Device_Config[in_Metro_Device_Id].metro_stpm_reg.DSPCTRL3,STPM_WAIT);

      }
      break;
      case LATCH_SW:
      {
        /* Set  latch SW 1 et 2 for the Two channels  the internal DSP Control Register 3*/
        p_Metro_Device_Config[in_Metro_Device_Id].metro_stpm_reg.DSPCTRL3 |= BIT_MASK_STPM_LATCH1|BIT_MASK_STPM_LATCH2;

        /* Now send data to the external chip */
        /* Calculate the base address to read inisde STPM chip  */
        /* the offset should be provided in 2 bytes format (16 bits by 16 bits) for STPM */
        tmp_addr = (uint32_t)((uint8_t*)&p_Metro_Device_Config[in_Metro_Device_Id].metro_stpm_reg.DSPCTRL3 - (uint8_t*)&p_Metro_Device_Config[in_Metro_Device_Id].metro_stpm_reg.DSPCTRL1)/2;

        /* Write register inside external chip */
        Metro_HAL_Stpm_write(in_Metro_Device_Id,(uint8_t*)&tmp_addr,1,&p_Metro_Device_Config[in_Metro_Device_Id].metro_stpm_reg.DSPCTRL3,STPM_WAIT);

      }
      break;
      case LATCH_SYN_SCS:
      {
        /* Latch external chip with syn PIN : 1 pulses is needed to latch */
        Metro_HAL_STPM_SYN_single_pulse(in_Metro_Device_Id);
      }
      break;
    }
     
  }

}

/**
  * @brief     This function gets the DSP registers inside Metrology devices
               Latch the device registers according to the latch type selection driving SYN pin
               or writing S/W Latchx bits in the DSP_CR3 register
               or setting auto-latch by S/W Auto Latch bit in the DSP_CR3 register
  * @param[in]   in_Metro_Device_Id (device ID), EXT1 to EXT4
  * @param[out]  none
  * @retval
  */
uint8_t Metro_HAL_Get_Data_device(METRO_NB_Device_t in_Metro_Device_Id)
{
  uint32_t tmp_addr = 0;
         
  /* After latch with syn pin or SW reg , we have to retreive metrology data from STPM external chip requested */
  /* from DSPEVENT1 to TOT_REG4 : 49 U32 reg from STPM*/
  /* Calculate the base address of Metrology data to read inisde STPM chip  */
  /* the offset should be provided in 2 bytes format (16 bits by 16 bits) for STPM */
  /* In case of STPM32, only one channel */


  if(in_Metro_Device_Id >= EXT1) 
  {
    if (p_Metro_Device_Config[in_Metro_Device_Id].device == STPM32)
    {
    tmp_addr = (uint32_t)((uint8_t*)&p_Metro_Device_Config[in_Metro_Device_Id].metro_stpm_reg.DSPEVENT1 - (uint8_t*)&p_Metro_Device_Config[in_Metro_Device_Id].metro_stpm_reg.DSPCTRL1)/2;
    uint32_t result = Metro_HAL_Stpm_Read(in_Metro_Device_Id,(uint8_t*)&tmp_addr,(METRO_STPM_DSP_DATA_REG_NB_BLOCKS + METRO_STPM_PH1_DATA_REG_NB_BLOCKS),&p_Metro_Device_Config[in_Metro_Device_Id].metro_stpm_reg.DSPEVENT1);
    if (result <= 0)
    {
    	return -1;
    }

    tmp_addr = (uint32_t)((uint8_t*)&p_Metro_Device_Config[in_Metro_Device_Id].metro_stpm_reg.TOT_REG1 - (uint8_t*)&p_Metro_Device_Config[in_Metro_Device_Id].metro_stpm_reg.DSPCTRL1)/2;
    result = Metro_HAL_Stpm_Read(in_Metro_Device_Id,(uint8_t*)&tmp_addr,METRO_STPM_TOT_DATA_REG_NB_BLOCKS,&p_Metro_Device_Config[in_Metro_Device_Id].metro_stpm_reg.TOT_REG1);
	if (result <= 0)
	{
		return -1;
	}
    
    }
    else
    {
    tmp_addr = (uint32_t)((uint8_t*)&p_Metro_Device_Config[in_Metro_Device_Id].metro_stpm_reg.DSPEVENT1 - (uint8_t*)&p_Metro_Device_Config[in_Metro_Device_Id].metro_stpm_reg.DSPCTRL1)/2;
    uint32_t result = Metro_HAL_Stpm_Read(in_Metro_Device_Id,(uint8_t*)&tmp_addr,METRO_STPM_DATA_REG_NB_BLOCKS,&p_Metro_Device_Config[in_Metro_Device_Id].metro_stpm_reg.DSPEVENT1);
    if (result <= 0)
   	{
   		return -1;
   	}
    }
  } 
  return 0;
}

/**
  * @brief      This function set the gain of the channel
  * @param[in]   in_Metro_Device_Id (device ID), HOST or EXT1 to EXT4
  * @param[in]   METRO_internal_Channel_t (Channel ID), Channel 1 or 2 ( according to device ) or CHANNEL_TAMPER
  * @param[in]   METRO_Current_t : X2 , X4 ,X8 , X16 current gain multiplicator
  * @param[out]  none
  * @retval      none
  */
void Metro_HAL_Set_Gain(METRO_NB_Device_t in_Metro_Device_Id,METRO_internal_Channel_t in_Metro_int_Channel, METRO_Gain_t in_Metro_Gain)
{

  uint32_t tmp_addr = 0;

  if(in_Metro_Device_Id >= EXT1) 
  {

  /* Set the new Current gain multiplicator for the channel requested */
    switch (in_Metro_Gain)
    {
      case (X2):
      {
        if ( in_Metro_int_Channel == INT_CHANNEL_1)
        {  
            p_Metro_Device_Config[in_Metro_Device_Id].metro_stpm_reg.DFECTRL1 &= ~ BIT_MASK_STPM_G_bit1;
            p_Metro_Device_Config[in_Metro_Device_Id].metro_stpm_reg.DFECTRL1 &= ~ BIT_MASK_STPM_G_bit2;
        }
        else if (( in_Metro_int_Channel == INT_CHANNEL_2) || (in_Metro_int_Channel == CHANNEL_TAMPER))
        {
            p_Metro_Device_Config[in_Metro_Device_Id].metro_stpm_reg.DFECTRL2 &= ~ BIT_MASK_STPM_G_bit1;
            p_Metro_Device_Config[in_Metro_Device_Id].metro_stpm_reg.DFECTRL2 &= ~ BIT_MASK_STPM_G_bit2;
        }
      }
      break;
      case (X4):
      {
        if ( in_Metro_int_Channel == INT_CHANNEL_1)
        {  
          p_Metro_Device_Config[in_Metro_Device_Id].metro_stpm_reg.DFECTRL1 |= BIT_MASK_STPM_G_bit1;
          p_Metro_Device_Config[in_Metro_Device_Id].metro_stpm_reg.DFECTRL1 &= ~ BIT_MASK_STPM_G_bit2;
        }
        else if (( in_Metro_int_Channel == INT_CHANNEL_2) || (in_Metro_int_Channel == CHANNEL_TAMPER))
        {
          p_Metro_Device_Config[in_Metro_Device_Id].metro_stpm_reg.DFECTRL2 |= BIT_MASK_STPM_G_bit1;
          p_Metro_Device_Config[in_Metro_Device_Id].metro_stpm_reg.DFECTRL2 &= ~ BIT_MASK_STPM_G_bit2;
        }        
      }
      break;
      case (X8):
      {
        if ( in_Metro_int_Channel == INT_CHANNEL_1)
        {  
          p_Metro_Device_Config[in_Metro_Device_Id].metro_stpm_reg.DFECTRL1 &= ~ BIT_MASK_STPM_G_bit1;
          p_Metro_Device_Config[in_Metro_Device_Id].metro_stpm_reg.DFECTRL1 |=  BIT_MASK_STPM_G_bit2;
        }
        else if (( in_Metro_int_Channel == INT_CHANNEL_2) || (in_Metro_int_Channel == CHANNEL_TAMPER))
        {
          p_Metro_Device_Config[in_Metro_Device_Id].metro_stpm_reg.DFECTRL2 &= ~ BIT_MASK_STPM_G_bit1;
          p_Metro_Device_Config[in_Metro_Device_Id].metro_stpm_reg.DFECTRL2 |=  BIT_MASK_STPM_G_bit2;
        }        
      }
      break;
      case (X16):
      {
        if ( in_Metro_int_Channel == INT_CHANNEL_1)
        {  
          p_Metro_Device_Config[in_Metro_Device_Id].metro_stpm_reg.DFECTRL1 |= BIT_MASK_STPM_G_bit1;
          p_Metro_Device_Config[in_Metro_Device_Id].metro_stpm_reg.DFECTRL1 |= BIT_MASK_STPM_G_bit2;
        }
        else if (( in_Metro_int_Channel == INT_CHANNEL_2) || (in_Metro_int_Channel == CHANNEL_TAMPER))
        {
          p_Metro_Device_Config[in_Metro_Device_Id].metro_stpm_reg.DFECTRL2 |= BIT_MASK_STPM_G_bit1;
          p_Metro_Device_Config[in_Metro_Device_Id].metro_stpm_reg.DFECTRL2 |= BIT_MASK_STPM_G_bit2;
        }        
      }
      break;
    }
      
      /* Now send data to the external chip */
      /* Calculate the base address to read inisde STPM chip  */
      /* the offset should be provided in 2 bytes format (16 bits by 16 bits) for STPM */
      tmp_addr = (uint32_t)((uint8_t*)&p_Metro_Device_Config[in_Metro_Device_Id].metro_stpm_reg.DFECTRL1 - (uint8_t*)&p_Metro_Device_Config[in_Metro_Device_Id].metro_stpm_reg.DSPCTRL1)/2;

     /* Write the 2 U32 registers inside external chip  for DFE CR1 and CR2 */
     Metro_HAL_Stpm_write(in_Metro_Device_Id,(uint8_t*)&tmp_addr,2,&p_Metro_Device_Config[in_Metro_Device_Id].metro_stpm_reg.DFECTRL1,STPM_WAIT);
  }
}    

/**
  * @brief      This function Get the gain of the channel requested
  * @param[in]   in_Metro_Device_Id (device ID), HOST or EXT1 to EXT4
  * @param[in]   METRO_internal_Channel_t (Channel ID), Channel 1 or 2 ( according to device ) or CHANNEL_TAMPER
  * @param[out]  none
  * @retval      METRO_Current_t : X2 , X4 ,X8 , X16 current gain multiplicator
  */
METRO_Gain_t Metro_HAL_Get_Gain(METRO_NB_Device_t in_Metro_Device_Id,METRO_internal_Channel_t in_Metro_int_Channel)
{

  METRO_Gain_t Gain = X2;
 
  if(in_Metro_Device_Id >= EXT1) 
  {

    if ( in_Metro_int_Channel == INT_CHANNEL_1)
    { 
      Gain = (METRO_Gain_t)((p_Metro_Device_Config[in_Metro_Device_Id].metro_stpm_reg.DFECTRL1&BIT_MASK_STPM_G_bit1)>>BIT_MASK_STPM_G_SHIFT);
      Gain |= (METRO_Gain_t)((p_Metro_Device_Config[in_Metro_Device_Id].metro_stpm_reg.DFECTRL1&BIT_MASK_STPM_G_bit2)>>BIT_MASK_STPM_G_SHIFT);
    }
    else if (( in_Metro_int_Channel == INT_CHANNEL_2) || (in_Metro_int_Channel == CHANNEL_TAMPER))
    {
      Gain = (METRO_Gain_t)((p_Metro_Device_Config[in_Metro_Device_Id].metro_stpm_reg.DFECTRL2&BIT_MASK_STPM_G_bit1)>>BIT_MASK_STPM_G_SHIFT);
      Gain |= (METRO_Gain_t)((p_Metro_Device_Config[in_Metro_Device_Id].metro_stpm_reg.DFECTRL2&BIT_MASK_STPM_G_bit2)>>BIT_MASK_STPM_G_SHIFT);
    }
  }
  return Gain;
} 

/**
  * @brief      This function Set the temperature compensation  of the channel requested
  * @param[in]   in_Metro_Device_Id (device ID), EXT1 to EXT4
  * @param[in]   METRO_internal_Channel_t (Channel ID), Channel 1 or 2 ( according to device )
  * @param[in]   u8 in_Metro_TC_Value  (possible values : 0 to 7)
  * @param[out]  None
  * @retval      None
  */
void Metro_HAL_Set_Temperature_Compensation(METRO_NB_Device_t in_Metro_Device_Id,METRO_internal_Channel_t in_Metro_int_Channel, uint8_t in_Metro_TC_Value)
{

  if(in_Metro_Device_Id >= EXT1) 
  {
    if ( in_Metro_int_Channel == INT_CHANNEL_1)
    { 
      /* Reset all bits for  TC1 value*/
      (p_Metro_Device_Config[in_Metro_Device_Id].metro_stpm_reg.DSPCTRL1) &= ~ BIT_MASK_STPM_TC;

      /* set  TC value to TC1 to RAM struct fir EXT chip */
      (p_Metro_Device_Config[in_Metro_Device_Id].metro_stpm_reg.DSPCTRL1) |= (((uint32_t)in_Metro_TC_Value) << BIT_MASK_STPM_TC_SHIFT);
    }
    else  if ( in_Metro_int_Channel == INT_CHANNEL_2)
    {
       /* Reset all bits for  TC2 value*/
      (p_Metro_Device_Config[in_Metro_Device_Id].metro_stpm_reg.DSPCTRL2) &= ~ BIT_MASK_STPM_TC;
        
      /* set  TC value to TC2 to RAM struct fir EXT chip */
      (p_Metro_Device_Config[in_Metro_Device_Id].metro_stpm_reg.DSPCTRL2) |= (((uint32_t)in_Metro_TC_Value) << BIT_MASK_STPM_TC_SHIFT);
    }
      
    /* Now Write the 2 U32 registers inside external chip  for DSP CR1 and CR2 -> start address is DSPCR1 -> address = 0 */
    uint32_t addr = 0;
    Metro_HAL_Stpm_write(in_Metro_Device_Id,(uint8_t*)&addr,2,&p_Metro_Device_Config[in_Metro_Device_Id].metro_stpm_reg.DSPCTRL1,STPM_WAIT);

  }
}
/**
  * @brief      This function Set the temperature compensation  of the channel requested
  * @param[in]   in_Metro_Device_Id (device ID), HOST or EXT1 to EXT4
  * @param[in]   in_Metro_int_Channel (Channel ID), Channel 1 or 2 ( according to device )
  * @param[out]  None
  * @retval      return u8 Metro_TC_Value  (possible values : 0 to 7)
  */

uint8_t Metro_HAL_Get_Temperature_Compensation(METRO_NB_Device_t in_Metro_Device_Id,METRO_internal_Channel_t in_Metro_int_Channel)
{
  uint8_t TC_Value = 0;
  
  if(in_Metro_Device_Id >= EXT1) 
  {
    if (in_Metro_int_Channel == INT_CHANNEL_1)
    { 
      /* get TC1 value from EXT chip  */
      TC_Value = ((p_Metro_Device_Config[in_Metro_Device_Id].metro_stpm_reg.DSPCTRL1)&BIT_MASK_STPM_TC)>> BIT_MASK_STPM_TC_SHIFT;
    }
    else if (in_Metro_int_Channel == INT_CHANNEL_2)
    {
      /* get TC2 value from EXT chip */
      TC_Value = ((p_Metro_Device_Config[in_Metro_Device_Id].metro_stpm_reg.DSPCTRL2)&BIT_MASK_STPM_TC)>> BIT_MASK_STPM_TC_SHIFT;     
    }
  }
  return (TC_Value);  
}

/**
  * @brief  Enable and set the tamper tolerance for detecting unbalanced active energy between the two current channels.
  * @param[in]   in_Metro_Device_Id (device ID), HOST or EXT1 to EXT4
  * @param[in]   METRO_internal_Channel_t (Channel ID), Channel tamper according to device
  * @param[in]   in_Metro_Tamper_Tolerance   TOL_12_5 = 0,  TOL_8_33 = 1, TOL_6_25 = 2, TOL_3_125 = 3 or NO_CHANGE_TOL = 4 ( if no change of tolerance is requested)
    TMP_TOL[1:0] Tamper tolerance
      0x00 TOL = 12.5%
      0x01 TOL = 8.33%
      0x10 TOL = 6.25%
      0x11 TOL = 3.125%  
  * @param[in]   in_Metro_CMD :   DEVICE_DISABLE = 0,  DEVICE_ENABLE = 1 No_CHANGE = 2 ( if No change is requested about enable bit)  
  * @param[out]  None
  * @retval      None
  */
void Metro_HAL_Set_Tamper(METRO_NB_Device_t in_Metro_Device_Id,METRO_internal_Channel_t in_Metro_int_Channel, METRO_Tamper_Tolerance_t in_Metro_Tamper_Tolerance,METRO_CMD_Device_t in_Metro_CMD)
{
  uint32_t tmp_addr =0;

  if(in_Metro_Device_Id >= EXT1) 
  {
  
    if (in_Metro_Tamper_Tolerance != NO_CHANGE_TOL)
    {
      /* Reset all bits for  Tamper tolerance value*/
      (p_Metro_Device_Config[in_Metro_Device_Id].metro_stpm_reg.DSPCTRL3) &= ~ BIT_MASK_STPM_TAMPER_TOLERANCE;
          
      /* set  new  Tamper tolerance to RAM struct for EXT chip */
      (p_Metro_Device_Config[in_Metro_Device_Id].metro_stpm_reg.DSPCTRL3) |= (((uint32_t)in_Metro_Tamper_Tolerance) << BIT_MASK_STPM_TAMPER_TOLERANCE_SHIFT);       
     }
        
     if (in_Metro_CMD != NO_CHANGE)
     {
       /* Reset enable/disable tamper bit */
       (p_Metro_Device_Config[in_Metro_Device_Id].metro_stpm_reg.DSPCTRL3) &= ~ BIT_MASK_STPM_TAMPER_ENABLE; 
          
       /* set  new enable/disable tamper bit to RAM struct for EXT chip */
       (p_Metro_Device_Config[in_Metro_Device_Id].metro_stpm_reg.DSPCTRL3) |= (((uint32_t)in_Metro_CMD) << BIT_MASK_STPM_TAMPER_ENABLE_SHIFT);    
     }

     /* Now send data to the external chip */
     /* Calculate the base address to read inisde STPM chip  */
     /* the offset should be provided in 2 bytes format (16 bits by 16 bits) for STPM */
     tmp_addr = (uint32_t)((uint8_t*)&p_Metro_Device_Config[in_Metro_Device_Id].metro_stpm_reg.DSPCTRL3 - (uint8_t*)&p_Metro_Device_Config[in_Metro_Device_Id].metro_stpm_reg.DSPCTRL1)/2;
        
     /* Now Write the 1 U32 registers inside external chip  for DSPCR3 -> start address is DSPCR1 -> address = 0 */
     Metro_HAL_Stpm_write(in_Metro_Device_Id,(uint8_t*)&tmp_addr,1,&p_Metro_Device_Config[in_Metro_Device_Id].metro_stpm_reg.DSPCTRL3,STPM_WAIT);

  }
}
/**
  * @brief   Get Tamper tolerance and TAMPER enable bit 
  * @param[in]   in_Metro_Device_Id (device ID), HOST or EXT1 to EXT4
  * @param[in]   METRO_internal_Channel_t (Channel ID), Channel tamper according to device
  * @param[out]  Metro_Tamper_Tolerance  : TOL_12_5 = 1,  TOL_8_33 = 2, TOL_6_25 = 3, TOL_3_125 = 4
  * @retval     in_Metro_CMD :   DEVICE_DISABLE = 0,  DEVICE_ENABLE = 1 
  */
METRO_CMD_Device_t  Metro_HAL_Get_Tamper(METRO_NB_Device_t in_Metro_Device_Id,METRO_internal_Channel_t in_Metro_int_Channel, METRO_Tamper_Tolerance_t * out_p_Tamper_Tolerance)
{

  METRO_CMD_Device_t CMD_Device = DEVICE_DISABLE;

  if(in_Metro_Device_Id >= EXT1) 
  {
    /* Make something if channel requested is tamper, ifnot nothing to do */
    if (in_Metro_int_Channel == CHANNEL_TAMPER)
    {  
      /* it s a host requested */
      /* Get Tamper Tolerance from EXT chip  */
      *out_p_Tamper_Tolerance = (METRO_Tamper_Tolerance_t) (((p_Metro_Device_Config[in_Metro_Device_Id].metro_stpm_reg.DSPCTRL3)&BIT_MASK_STPM_TAMPER_TOLERANCE)>> BIT_MASK_STPM_TAMPER_TOLERANCE_SHIFT);

      /* Get Tamper Enable bit from EXT chip  */
      CMD_Device = (METRO_CMD_Device_t)(((p_Metro_Device_Config[in_Metro_Device_Id].metro_stpm_reg.DSPCTRL3)&BIT_MASK_STPM_TAMPER_ENABLE)>> BIT_MASK_STPM_TAMPER_ENABLE_SHIFT);   
    }
  }
  return (CMD_Device);  
}

/**
  * @brief       Enable and set ZCR config.
  * @param[in]   in_Metro_Device_Id (device ID), HOST or EXT1 to EXT4
  * @param[in]   METRO_ZCR_Sel_t in_Metro_ZCR_Sel_config : ZCR_SEL_V1 = 0, ZCR_SEL_C1, ZCR_SEL_V2, ZCR_SEL_C2
  * @param[in]   in_Metro_CMD :   DEVICE_DISABLE = 0,  DEVICE_ENABLE = 1 No_CHANGE = 2 ( if No change is requested about enable bit)  
  * @param[out]  None
  * @retval      None
  */
void Metro_HAL_Set_ZCR(METRO_NB_Device_t in_Metro_Device_Id, METRO_ZCR_Sel_t in_Metro_ZCR_Sel_config,METRO_CMD_Device_t in_Metro_CMD)
{
  uint32_t tmp_addr =0;

  if(in_Metro_Device_Id >= EXT1) 
  {
  
    if (in_Metro_ZCR_Sel_config != NO_CHANGE_ZCR)
    {
      /* Reset all bits for  ZCR select value*/
      (p_Metro_Device_Config[in_Metro_Device_Id].metro_stpm_reg.DSPCTRL3) &= ~ BIT_MASK_STPM_ZCR_SEL;
        
      /* set  new  ZCR select value to  RAM struct for EXT chip */
      (p_Metro_Device_Config[in_Metro_Device_Id].metro_stpm_reg.DSPCTRL3) |= (((uint32_t)in_Metro_ZCR_Sel_config) << BIT_MASK_STPM_ZCR_SEL_SHIFT);
        
    }
      
    /* Disable ZCR requested */
    if (in_Metro_CMD == DEVICE_DISABLE)
    {
      /* Reset ZCR enable bit to disable ZCR feature */
      (p_Metro_Device_Config[in_Metro_Device_Id].metro_stpm_reg.DSPCTRL3) &= ~ BIT_MASK_STPM_ZCR_ENA; 
          
    } /* Enable Requested */
    else if (in_Metro_CMD == DEVICE_ENABLE)
    {
      /*  enable ZCR  bit to enable ZCR feature to RAM struct for EXT chip */
      (p_Metro_Device_Config[in_Metro_Device_Id].metro_stpm_reg.DSPCTRL3) |= BIT_MASK_STPM_ZCR_ENA;    
    }

    /* Now send data to the external chip */
    /* Calculate the base address to read inisde STPM chip  */
    /* the offset should be provided in 2 bytes format (16 bits by 16 bits) for STPM */
    tmp_addr = (uint32_t)((uint8_t*)&p_Metro_Device_Config[in_Metro_Device_Id].metro_stpm_reg.DSPCTRL3 - (uint8_t*)&p_Metro_Device_Config[in_Metro_Device_Id].metro_stpm_reg.DSPCTRL1)/2;
      
    /* Now Write the 1 U32 registers inside external chip  for DSPCR3 -> start address is DSPCR3 */
    Metro_HAL_Stpm_write(in_Metro_Device_Id,(uint8_t*)&tmp_addr,1,&p_Metro_Device_Config[in_Metro_Device_Id].metro_stpm_reg.DSPCTRL3,STPM_WAIT);

  }
}

/*
  * @brief       Get ZCR config.
  * @param[in]   in_Metro_Device_Id (device ID), HOST or EXT1 to EXT4
  * @param[out]   METRO_ZCR_Sel_t out_p_Metro_ZCR_Sel_config : ZCR_SEL_V1 = 0, ZCR_SEL_C1, ZCR_SEL_V2, ZCR_SEL_C2
  * @retval      METRO_CMD_Device_t :   DEVICE_DISABLE = 0,  DEVICE_ENABLE = 1  
  */
METRO_CMD_Device_t  Metro_HAL_Get_ZCR(METRO_NB_Device_t in_Metro_Device_Id, METRO_ZCR_Sel_t * out_p_Metro_ZCR_Sel_config)
{

  METRO_CMD_Device_t CMD_Device = DEVICE_DISABLE;

  if(in_Metro_Device_Id >= EXT1) 
  {
    /* Get ZCR config from EXT chip  */
    *out_p_Metro_ZCR_Sel_config = (METRO_ZCR_Sel_t) (((p_Metro_Device_Config[in_Metro_Device_Id].metro_stpm_reg.DSPCTRL3)&BIT_MASK_STPM_ZCR_SEL)>> BIT_MASK_STPM_ZCR_SEL_SHIFT);

    /* Get ZCR Enable bit from EXT chip  */
    CMD_Device = (METRO_CMD_Device_t)(((p_Metro_Device_Config[in_Metro_Device_Id].metro_stpm_reg.DSPCTRL3)&BIT_MASK_STPM_ZCR_ENA)>> BIT_MASK_STPM_ZCR_ENA_SHIFT);   
  }
  return (CMD_Device);  
}

/**
  * @brief       Set CLK config.
  * @param[in]   in_Metro_Device_Id (device ID), HOST or EXT1 to EXT4
  * @param[in]   METRO_CLK_Sel_t in_Metro_CLK_Sel_config :   CLK_SEL_7KHz = 0,  CLK_SEL_4MHz, CLK_SEL_4MHz_50,CLK_SEL_16MHz
  * @param[in]   METRO_CMD_Device_t :   DEVICE_DISABLE = 0,  DEVICE_ENABLE = 1  
  * @retval      METRO_CMD_Device_t :   DEVICE_DISABLE = 0,  DEVICE_ENABLE = 1  

  */
void Metro_HAL_Set_CLK(METRO_NB_Device_t in_Metro_Device_Id, METRO_CLK_Sel_t in_Metro_CLK_Sel_config,METRO_CMD_Device_t in_Metro_CMD)
{
  uint32_t tmp_addr =0;

  if(in_Metro_Device_Id >= EXT1) 
  {  
    if (in_Metro_CLK_Sel_config != NO_CHANGE_CLK)
    {
      /* Reset all bits for  CLK select value*/
      (p_Metro_Device_Config[in_Metro_Device_Id].metro_stpm_reg.DSPCTRL3) &= ~ BIT_MASK_STPM_CLK_SEL;
        
      /* set  new  CLK select value to  RAM struct for EXT chip */
      (p_Metro_Device_Config[in_Metro_Device_Id].metro_stpm_reg.DSPCTRL3) |= (((uint32_t)in_Metro_CLK_Sel_config) << BIT_MASK_STPM_CLK_SEL_SHIFT);
        
    }
      
    /* Disable CLK requested */
    if (in_Metro_CMD == DEVICE_DISABLE)
    {
      /* SET CLK  bit to disable CLK feature */
      (p_Metro_Device_Config[in_Metro_Device_Id].metro_stpm_reg.DSPCTRL3) |= BIT_MASK_STPM_CLK_ENA;    
    
    } /* Enable Requested */
    else if (in_Metro_CMD == DEVICE_ENABLE)
    {
      /*  Disable CLK  bit to enable CLK feature to RAM struct for EXT chip */
      (p_Metro_Device_Config[in_Metro_Device_Id].metro_stpm_reg.DSPCTRL3) &= ~ BIT_MASK_STPM_CLK_ENA; 

    }

    /* Now send data to the external chip */
    /* Calculate the base address to read inisde STPM chip  */
    /* the offset should be provided in 2 bytes format (16 bits by 16 bits) for STPM */
    tmp_addr = (uint32_t)((uint8_t*)&p_Metro_Device_Config[in_Metro_Device_Id].metro_stpm_reg.DSPCTRL3 - (uint8_t*)&p_Metro_Device_Config[in_Metro_Device_Id].metro_stpm_reg.DSPCTRL1)/2;
      
    /* Now Write the 1 U32 registers inside external chip  for DSPCR3 -> start address is DSPCR3 */
    Metro_HAL_Stpm_write(in_Metro_Device_Id,(uint8_t*)&tmp_addr,1,&p_Metro_Device_Config[in_Metro_Device_Id].metro_stpm_reg.DSPCTRL3,STPM_WAIT);
  }
}

/*
  * @brief        Get CLK config.
  * @param[in]   in_Metro_Device_Id (device ID), HOST or EXT1 to EXT4
  * @param[out]   METRO_CLK_Sel_t out_p_Metro_CLK_Sel_config :   CLK_SEL_7KHz = 0,  CLK_SEL_4MHz, CLK_SEL_4MHz_50,CLK_SEL_16MHz,
  * @retval      METRO_CMD_Device_t :   DEVICE_DISABLE = 0,  DEVICE_ENABLE = 1  
  */
METRO_CMD_Device_t  Metro_HAL_Get_CLK(METRO_NB_Device_t in_Metro_Device_Id, METRO_CLK_Sel_t * out_p_Metro_CLK_Sel_config)
{

  METRO_CMD_Device_t CMD_Device = DEVICE_DISABLE;

  if(in_Metro_Device_Id >= EXT1) 
  {
    /* Get CLK config from EXT chip  */
    *out_p_Metro_CLK_Sel_config = (METRO_CLK_Sel_t) (((p_Metro_Device_Config[in_Metro_Device_Id].metro_stpm_reg.DSPCTRL3)&BIT_MASK_STPM_CLK_SEL)>> BIT_MASK_STPM_CLK_SEL_SHIFT);

    /* Get CLK Enable bit from EXT chip  */
    CMD_Device = (METRO_CMD_Device_t)(((p_Metro_Device_Config[in_Metro_Device_Id].metro_stpm_reg.DSPCTRL3)&BIT_MASK_STPM_CLK_ENA)>> BIT_MASK_STPM_CLK_ENA_SHIFT);   
      
    /* reverse the value read inside register,  because 0 : means CLK enable and 1 means disable for CLK output */
    if (CMD_Device == DEVICE_ENABLE)
    {
      CMD_Device = DEVICE_DISABLE;
    }
    else if (CMD_Device == DEVICE_DISABLE)
    {
      CMD_Device = DEVICE_ENABLE;      
    }
  }
  return (CMD_Device);    
}

/**
  * @brief       Set Led Power Config.
  * @param[in]   METRO_NB_Device_t in_Metro_Device (Device ID ), HOST or EXT1 to EXT4 
  * @param[in]   METRO_LED_Selection_t in_Metro_LED_Selection  :     LED1 = 1,  LED2 = 2 
  * @param[in]   METRO_LED_Power_selection_t in_Metro_Power_Selection :   LED_W_ACTIVE = 0,  LED_F_ACTIVE, LED_REACTIVE, LED_APPARENT_RMS 
  * @param[Out]  None 
  * @retval      None
  */
void Metro_HAL_Set_Led_Power_Config(METRO_NB_Device_t in_Metro_Device, METRO_LED_Selection_t in_Metro_LED_Selection,METRO_LED_Power_selection_t in_Metro_Power_Selection)
{ 
  if(in_Metro_Device >= EXT1) 
  {
    /* Set params for Good External LEd pin of external chip (1 or 2)*/
    if (in_Metro_LED_Selection == LED1)
    {  
      
      /* Reset all bits for LED power selection  */
      (p_Metro_Device_Config[in_Metro_Device].metro_stpm_reg.DSPCTRL1) &= ~ BIT_MASK_STPM_LED_POWER_SEL;

      /* Set new LEd power selection config  */
      (p_Metro_Device_Config[in_Metro_Device].metro_stpm_reg.DSPCTRL1) |= (((uint32_t)in_Metro_Power_Selection) << BIT_MASK_STPM_LED_POWER_SEL_SHIFT);
      
    }
    else if (in_Metro_LED_Selection == LED2)
    {
         
      /* Reset all bits for LED power selection    */
      (p_Metro_Device_Config[in_Metro_Device].metro_stpm_reg.DSPCTRL2) &= ~ BIT_MASK_STPM_LED_POWER_SEL;

      /* Set new LEd power slection config    */
      (p_Metro_Device_Config[in_Metro_Device].metro_stpm_reg.DSPCTRL2) |= (((uint32_t)in_Metro_Power_Selection) << BIT_MASK_STPM_LED_POWER_SEL_SHIFT);
        
    }
        
      /* Now Write the 2 U32 registers inside external chip  for DSPCR -> start address is DSPCR1 */
    uint32_t addr = 0;
    Metro_HAL_Stpm_write(in_Metro_Device,(uint8_t*)&addr,2,&p_Metro_Device_Config[in_Metro_Device].metro_stpm_reg.DSPCTRL1,STPM_WAIT);
  }
}

/**
  * @brief       Set Led Channel Config.
  * @param[in]   METRO_NB_Device_t in_Metro_Device (Device ID ), HOST or EXT1 to EXT4 
  * @param[in]   METRO_LED_Selection_t in_Metro_LED_Selection  :     LED1 = 1,  LED2 = 2 
  * @param[in]   METRO_LED_Channel_t in_Metro_LED_Channel :    PRIMARY = 0,  SECONDARY, ALGEBRIC, SIGMA_DELTA  
  * @param[Out]  None 
  * @retval      None
  */
void Metro_HAL_Set_Led_Channel_Config(METRO_NB_Device_t in_Metro_Device, METRO_LED_Selection_t in_Metro_LED_Selection,METRO_LED_Channel_t in_Metro_LED_Channel)
{ 

  if(in_Metro_Device >= EXT1) 
  {
    /* Set params for Good External LEd pin of external chip (1 or 2)*/
    if (in_Metro_LED_Selection == LED1)
    {  
      /* Reset all bits for LED Channel selection */
      (p_Metro_Device_Config[in_Metro_Device].metro_stpm_reg.DSPCTRL1) &= ~ BIT_MASK_STPM_LED_CH_SEL;

       /* Set new LEd Channel config  */
      (p_Metro_Device_Config[in_Metro_Device].metro_stpm_reg.DSPCTRL1) |= (((uint32_t)in_Metro_LED_Channel) << BIT_MASK_STPM_LED_CH_SEL_SHIFT);    
    }
    else if (in_Metro_LED_Selection == LED2)
    {
      /* Reset all bits for LED Channel selection PROG   */
      (p_Metro_Device_Config[in_Metro_Device].metro_stpm_reg.DSPCTRL2) &= ~ BIT_MASK_STPM_LED_CH_SEL;

      /* Set new LEd Channel config config  */
      (p_Metro_Device_Config[in_Metro_Device].metro_stpm_reg.DSPCTRL2) |= (((uint32_t)in_Metro_LED_Channel) << BIT_MASK_STPM_LED_CH_SEL_SHIFT);     
    }
        
    /* Now Write the 2 U32 registers inside external chip  for DSPCR -> start address is DSPCR1 */
    uint32_t addr = 0;
    Metro_HAL_Stpm_write(in_Metro_Device,(uint8_t*)&addr,2,&p_Metro_Device_Config[in_Metro_Device].metro_stpm_reg.DSPCTRL1,STPM_WAIT);
  }
}
/**
  * @brief       Get Led Power Config.
  * @param[in]   METRO_NB_Device_t in_Metro_Device (Device ID ), HOST or EXT1 to EXT4 
  * @param[in]   METRO_LED_Selection_t in_Metro_LED_Selection  :     LED1 = 1,  LED2 = 2 
  * @param[out]  METRO_LED_Power_selection_t * out_p_Metro_Power_Selection :   LED_W_ACTIVE = 0,  LED_F_ACTIVE, LED_REACTIVE, LED_APPARENT_RMS 
  * @retval      None
  */
void Metro_HAL_Get_Led_Power_Config(METRO_NB_Device_t in_Metro_Device, METRO_LED_Selection_t in_Metro_LED_Selection,METRO_LED_Power_selection_t * out_p_Metro_Power_Selection)
{
  if(in_Metro_Device >= EXT1) 
  {
    /* Get params for Good External LEd pin of external chip (1 or 2)*/
    if (in_Metro_LED_Selection == LED1)
    {  
      /* Get  LEd power selection config   */
       *out_p_Metro_Power_Selection = (METRO_LED_Power_selection_t) (((p_Metro_Device_Config[in_Metro_Device].metro_stpm_reg.DSPCTRL1)&BIT_MASK_STPM_LED_POWER_SEL)>> BIT_MASK_STPM_LED_POWER_SEL_SHIFT);
    }
    else if (in_Metro_LED_Selection == LED2)
    {
      /* Get  LEd power selection config   */
       *out_p_Metro_Power_Selection = (METRO_LED_Power_selection_t) (((p_Metro_Device_Config[in_Metro_Device].metro_stpm_reg.DSPCTRL2)&BIT_MASK_STPM_LED_POWER_SEL)>> BIT_MASK_STPM_LED_POWER_SEL_SHIFT);
    }
  }
}
/**
  * @brief       Get Led Channel Config.
  * @param[in]   METRO_NB_Device_t in_Metro_Device (Device ID ), HOST or EXT1 to EXT4 
  * @param[in]   METRO_LED_Selection_t in_Metro_LED_Selection  :     LED1 = 1,  LED2 = 2 
  * @param[out]  METRO_LED_Channel_t * out_p_Metro_LED_Channel :    PRIMARY = 0,  SECONDARY, ALGEBRIC, SIGMA_DELTA  
  * @retval      None
  */
void Metro_HAL_Get_Led_Channel_Config(METRO_NB_Device_t in_Metro_Device, METRO_LED_Selection_t in_Metro_LED_Selection,METRO_LED_Channel_t * out_p_Metro_LED_Channel)
{
  if(in_Metro_Device >= EXT1) 
  {
    /* Get params for Good External LEd pin of external chip (1 or 2)*/
    if (in_Metro_LED_Selection == LED1)
    {  
      /* Get  LEd Channel config  */
       *out_p_Metro_LED_Channel = (METRO_LED_Channel_t) (((p_Metro_Device_Config[in_Metro_Device].metro_stpm_reg.DSPCTRL1)&BIT_MASK_STPM_LED_CH_SEL)>> BIT_MASK_STPM_LED_CH_SEL_SHIFT);
    }
    else if (in_Metro_LED_Selection == LED2)
    {
      /* Get  LEd Channel config  */
       *out_p_Metro_LED_Channel = (METRO_LED_Channel_t) (((p_Metro_Device_Config[in_Metro_Device].metro_stpm_reg.DSPCTRL2)&BIT_MASK_STPM_LED_CH_SEL)>> BIT_MASK_STPM_LED_CH_SEL_SHIFT);
    }
  }
}
/**
  * @brief       Set Led Speed divisor.
  * @param[in]   METRO_NB_Device_t in_Metro_Device (Device ID ), HOST or EXT1 to EXT4 
  * @param[in]   METRO_LED_Selection_t in_Metro_LED_Selection  :     LED1 = 1,  LED2 = 2 
  * @param[in]   u8 in_Metro_LED_Speed_divisor  :     0 to 15 ( 4 bits only used amoung the U8) 
  * @param[Out]  None 
  * @retval      None
  */
void Metro_HAL_Set_Led_Speed_divisor(METRO_NB_Device_t in_Metro_Device, METRO_LED_Selection_t in_Metro_LED_Selection,uint8_t in_Metro_LED_Speed_divisor)
{

  if(in_Metro_Device >= EXT1) 
  {
    /* Set params for Good External LEd pin of external chip (1 or 2)*/
    if (in_Metro_LED_Selection == LED1)
    {  
      /* Reset all bits for LED Speed divider   */
      (p_Metro_Device_Config[in_Metro_Device].metro_stpm_reg.DSPCTRL1) &= ~ BIT_MASK_STPM_LED_SPEED_DIV;

      /* Set new LEd Speed divider  config  */
      (p_Metro_Device_Config[in_Metro_Device].metro_stpm_reg.DSPCTRL1) |= (((uint32_t)in_Metro_LED_Speed_divisor) << BIT_MASK_STPM_LED_SPEED_DIV_SHIFT);
      
    }
    else if (in_Metro_LED_Selection == LED2)
    {      
      /* Reset all bits for LED Speed divider     */
      (p_Metro_Device_Config[in_Metro_Device].metro_stpm_reg.DSPCTRL2) &= ~ BIT_MASK_STPM_LED_SPEED_DIV;

      /* Set new LEd Speed divider  config    */
      (p_Metro_Device_Config[in_Metro_Device].metro_stpm_reg.DSPCTRL2) |= (((uint32_t)in_Metro_LED_Speed_divisor) << BIT_MASK_STPM_LED_SPEED_DIV_SHIFT);     
    }
      
    /* Now Write the 2 U32 registers inside external chip  for DSPCR -> start address is DSPCR1 */
    uint32_t addr = 0;
    Metro_HAL_Stpm_write(in_Metro_Device,(uint8_t*)&addr,2,&p_Metro_Device_Config[in_Metro_Device].metro_stpm_reg.DSPCTRL1,STPM_WAIT);
  }
}

/**
  * @brief       Get Led Speed divisor.
  * @param[in]   METRO_NB_Device_t in_Metro_Device (Device ID ), HOST or EXT1 to EXT4 
  * @param[in]   METRO_LED_Selection_t in_Metro_LED_Selection  :     LED1 = 1,  LED2 = 2 
  * @retval      u8 Metro_LED_Speed_divisor  :     0 to 15 ( 4 bits only used amoung the U8)
  */
uint8_t Metro_HAL_Get_Led_Speed_divisor(METRO_NB_Device_t in_Metro_Device,METRO_LED_Selection_t in_Metro_LED_Selection)
{
  uint8_t Led_speed_divisor = 0;

  if(in_Metro_Device >= EXT1) 
  {
    /* Get LEd Speed diviser config for Good External LEd pin of external chip (1 or 2)*/
    if (in_Metro_LED_Selection == LED1)
    {      
      /* Get  LEd Speed diviser config  */
       Led_speed_divisor = (uint8_t) (((p_Metro_Device_Config[in_Metro_Device].metro_stpm_reg.DSPCTRL1)&BIT_MASK_STPM_LED_SPEED_DIV)>> BIT_MASK_STPM_LED_SPEED_DIV_SHIFT);
    }
    else if (in_Metro_LED_Selection == LED2)
    { 
      /* Get  LEd Speed diviser config  */
       Led_speed_divisor = (uint8_t) (((p_Metro_Device_Config[in_Metro_Device].metro_stpm_reg.DSPCTRL2)&BIT_MASK_STPM_LED_SPEED_DIV)>> BIT_MASK_STPM_LED_SPEED_DIV_SHIFT); 
    }
  }
  return Led_speed_divisor;
}

/**
  * @brief       Set Led On Off config.
  * @param[in]   in_Metro_Device_Id (device ID), HOST or EXT1 to EXT4
  * @param[in]   METRO_LED_Selection_t in_Metro_LED_Selection  :     LED1 = 1,  LED2 = 2 
  * @param[in]   METRO_CMD_Device_t :   DEVICE_DISABLE = 0,  DEVICE_ENABLE = 1  
  * @retval      None 
  */
void Metro_HAL_Set_Led_On_Off(METRO_NB_Device_t in_Metro_Device_Id, METRO_LED_Selection_t in_Metro_LED_Selection,METRO_CMD_Device_t in_Metro_CMD)
{
  uint32_t tmp_addr =0;

  if(in_Metro_Device_Id >= EXT1) 
  {  
    if (in_Metro_LED_Selection == LED1)
    {       
      /* Disable LED output requested */
      if (in_Metro_CMD == DEVICE_DISABLE)
      {
        /* SET Led  bit to disable LED feature */
         (p_Metro_Device_Config[in_Metro_Device_Id].metro_stpm_reg.DSPCTRL3) |= BIT_MASK_STPM_LED1_OFF;    
      
      } /* Enable Led output Requested */
      else if (in_Metro_CMD == DEVICE_ENABLE)
      {
        /*  Disable Led  bit to enable LEd feature to RAM struct for EXT chip */
        (p_Metro_Device_Config[in_Metro_Device_Id].metro_stpm_reg.DSPCTRL3) &= ~ BIT_MASK_STPM_LED1_OFF; 
      }
    }
    else if (in_Metro_LED_Selection == LED2)
    {
      /* Disable LED output requested */
      if (in_Metro_CMD == DEVICE_DISABLE)
      {
        /* SET Led  bit to disable LED feature */
         (p_Metro_Device_Config[in_Metro_Device_Id].metro_stpm_reg.DSPCTRL3) |= BIT_MASK_STPM_LED2_OFF;    
      
      } /* Enable Led output Requested */
      else if (in_Metro_CMD == DEVICE_ENABLE)
      {
        /*  Disable Led  bit to enable LEd feature to RAM struct for EXT chip */
        (p_Metro_Device_Config[in_Metro_Device_Id].metro_stpm_reg.DSPCTRL3) &= ~ BIT_MASK_STPM_LED2_OFF; 

      }
        
    }

    /* Now send data to the external chip */
    /* Calculate the base address to read inisde STPM chip  */
    /* the offset should be provided in 2 bytes format (16 bits by 16 bits) for STPM */
    tmp_addr = (uint32_t)((uint8_t*)&p_Metro_Device_Config[in_Metro_Device_Id].metro_stpm_reg.DSPCTRL3 - (uint8_t*)&p_Metro_Device_Config[in_Metro_Device_Id].metro_stpm_reg.DSPCTRL1)/2;
    
    /* Now Write the 1 U32 registers inside external chip  for DSPCR3 -> start address is DSPCR3 */
    Metro_HAL_Stpm_write(in_Metro_Device_Id,(uint8_t*)&tmp_addr,1,&p_Metro_Device_Config[in_Metro_Device_Id].metro_stpm_reg.DSPCTRL3,STPM_WAIT);

  }
}
/*
  * @brief        Get Led On Off config.
  * @param[in]   in_Metro_Device_Id (device ID), HOST or EXT1 to EXT4
  * @param[in]   METRO_LED_Selection_t in_Metro_LED_Selection  :     LED1 = 1,  LED2 = 2 
  * @retval      METRO_CMD_Device_t :   DEVICE_DISABLE = 0,  DEVICE_ENABLE = 1  
  */
METRO_CMD_Device_t  Metro_HAL_Get_Led_On_Off(METRO_NB_Device_t in_Metro_Device_Id, METRO_LED_Selection_t in_Metro_LED_Selection)
{

  METRO_CMD_Device_t CMD_Device = DEVICE_ENABLE;

  if(in_Metro_Device_Id >= EXT1) 
  {

    if (in_Metro_LED_Selection == LED1)
    {       
      /* Get LED 1 Enable bit from EXT chip  */
      CMD_Device = (METRO_CMD_Device_t)(((p_Metro_Device_Config[in_Metro_Device_Id].metro_stpm_reg.DSPCTRL3)&BIT_MASK_STPM_LED1_OFF)>> BIT_MASK_STPM_LED1_OFF_SHIFT);   
        
      /* reverse the value read inside register,  because 0 : means LEED enable and 1 means disable for LEDs output */
      if (CMD_Device == DEVICE_ENABLE)
      {
        CMD_Device = DEVICE_DISABLE;
      }
      else if (CMD_Device == DEVICE_DISABLE)
      {
        CMD_Device = DEVICE_ENABLE;      
      }
    }
    else if (in_Metro_LED_Selection == LED2)
    {
      /* Get LED 2 Enable bit from EXT chip  */
      CMD_Device = (METRO_CMD_Device_t)(((p_Metro_Device_Config[in_Metro_Device_Id].metro_stpm_reg.DSPCTRL3)&BIT_MASK_STPM_LED2_OFF)>> BIT_MASK_STPM_LED2_OFF_SHIFT);   
        
      /* reverse the value read inside register,  because 0 : means LED enable and 1 means disable for LED output */
      if (CMD_Device == DEVICE_ENABLE)
      {
        CMD_Device = DEVICE_DISABLE;
      }
      else if (CMD_Device == DEVICE_DISABLE)
      {
        CMD_Device = DEVICE_ENABLE;      
      }      
    }
  }
  return (CMD_Device);    
}

/**
  * @brief  Set VRef of device according to internal channel
  * @param[in]   in_Metro_Device_Id (device ID), HOST or EXT1 to EXT4
  * @param[in]   METRO_internal_Channel_t (Channel ID), Channel 1 or 2 ( according to device )
  * @param[in]   in_Metro_Vref :INT_VREF , EXT_VREF
  * @param[out]  None
  * @retval      None
  */
void Metro_HAL_Set_Vref(METRO_NB_Device_t in_Metro_Device_Id,METRO_internal_Channel_t in_Metro_int_Channel, METRO_Vref_t in_Metro_Vref)
{
  if(in_Metro_Device_Id >= EXT1) 
  {
    if ( in_Metro_int_Channel == INT_CHANNEL_1)
    {
      if (in_Metro_Vref == EXT_VREF)
      {  
        /* Disable bit ENVREF1 to force EXT VREF use */
        (p_Metro_Device_Config[in_Metro_Device_Id].metro_stpm_reg.DSPCTRL1) &= ~ BIT_MASK_STPM_ENVREF1;
      }
      else if (in_Metro_Vref == INT_VREF)
      {  
        /* set bit ENVREF1 to force Internal Vref use */
        (p_Metro_Device_Config[in_Metro_Device_Id].metro_stpm_reg.DSPCTRL1) |= BIT_MASK_STPM_ENVREF1;
      }
    }
    else  if ( in_Metro_int_Channel == INT_CHANNEL_2)
    {
      if (in_Metro_Vref == EXT_VREF)
      {  
        /* Disable bit ENVREF2 to force EXT VREF use */
        (p_Metro_Device_Config[in_Metro_Device_Id].metro_stpm_reg.DSPCTRL2) &= ~ BIT_MASK_STPM_ENVREF2;
      }
      else if (in_Metro_Vref == INT_VREF)
      {  
        /* set bit ENVREF1 to force Internal Vref use */
        (p_Metro_Device_Config[in_Metro_Device_Id].metro_stpm_reg.DSPCTRL2) |= BIT_MASK_STPM_ENVREF2;
      }
    }   
    /* Now Write the 2 U32 registers inside external chip  for DSP CR1 and CR2 -> start address is DSPCR1 -> address = 0 */
    uint32_t addr = 0;
    Metro_HAL_Stpm_write(in_Metro_Device_Id,(uint8_t*)&addr,2,&p_Metro_Device_Config[in_Metro_Device_Id].metro_stpm_reg.DSPCTRL1,STPM_WAIT);
  }
}

/**
  * @brief  Get VRef  of device according to internal channel
  * @param[in]   in_Metro_Device_Id (device ID), HOST or EXT1 to EXT4
  * @param[in]   METRO_internal_Channel_t (Channel ID), Channel 1 or 2 ( according to device )
  * @param[out]  None
* @retval        METRO_Vref_t :  EXT_VREF = 0, INT_VREF = 1
  */
METRO_Vref_t Metro_HAL_Get_Vref(METRO_NB_Device_t in_Metro_Device_Id,METRO_internal_Channel_t in_Metro_int_Channel)
{
  METRO_Vref_t  vref = EXT_VREF ;

  if(in_Metro_Device_Id >= EXT1) 
  {  
    if ( in_Metro_int_Channel == INT_CHANNEL_1)
    {
      /* Get bit ENVREF1 */
      vref =(METRO_Vref_t)(((p_Metro_Device_Config[in_Metro_Device_Id].metro_stpm_reg.DSPCTRL1)&BIT_MASK_STPM_ENVREF1) >> BIT_MASK_STPM_ENVREF1_SHIFT);
    }
    else  if (in_Metro_int_Channel == INT_CHANNEL_2)
    {
      /* Get bit ENVREF2  */
      vref=(METRO_Vref_t)(((p_Metro_Device_Config[in_Metro_Device_Id].metro_stpm_reg.DSPCTRL2)&BIT_MASK_STPM_ENVREF2) >> BIT_MASK_STPM_ENVREF2_SHIFT);
    }   
  }
  return vref;
}

/**
  * @brief  enable/disable HightPass filters ( DC remover )  for Current  Channel (  C )
  * @param[in]   in_Metro_Device_Id (device ID), HOST or EXT1 to EXT4
  * @param[in]   METRO_internal_Channel_t (Channel ID), Channel 1 or 2 ( according to device )
  * @param[in]   in_Metro_CMD :   DEVICE_DISABLE = 0,  DEVICE_ENABLE = 1
  * @param[out]  None
  * @retval      None
  */
void Metro_HAL_Set_Current_HP_Filter(METRO_NB_Device_t in_Metro_Device_Id,METRO_internal_Channel_t in_Metro_int_Channel, METRO_CMD_Device_t in_Metro_CMD)
{
  if(in_Metro_Device_Id >= EXT1) 
  {
    if ( in_Metro_int_Channel == INT_CHANNEL_1)
    {
      /* Reset enable/disable Current_HP_Filter bit */
      (p_Metro_Device_Config[in_Metro_Device_Id].metro_stpm_reg.DSPCTRL1) &= ~ BIT_MASK_STPM_CURR_HPF_BYPASS; 
          
      /* set  new enable/disable Current_HP_Filter bit to RAM struct for EXT chip */
      (p_Metro_Device_Config[in_Metro_Device_Id].metro_stpm_reg.DSPCTRL1) |= (((uint32_t)in_Metro_CMD) << BIT_MASK_STPM_CURR_HPF_BYPASS_SHIFT);
    }
    else  if( in_Metro_int_Channel == INT_CHANNEL_2)
    {
      /* Reset enable/disable Current_HP_Filter bit */
      (p_Metro_Device_Config[in_Metro_Device_Id].metro_stpm_reg.DSPCTRL2) &= ~ BIT_MASK_STPM_CURR_HPF_BYPASS; 
          
      /* set  new enable/disable Current_HP_Filter bit to RAM struct for EXT chip */
      (p_Metro_Device_Config[in_Metro_Device_Id].metro_stpm_reg.DSPCTRL2) |= (((uint32_t)in_Metro_CMD) << BIT_MASK_STPM_CURR_HPF_BYPASS_SHIFT);    
    }

    /* Now send data to the external chip */      
    /* Now Write the 2 U32 registers inside external chip  for DSPCR1 -> start address is DSPCR1 -> address = 0 */
    uint32_t addr = 0;
    Metro_HAL_Stpm_write(in_Metro_Device_Id,(uint8_t*)&addr,2,&p_Metro_Device_Config[in_Metro_Device_Id].metro_stpm_reg.DSPCTRL1,STPM_WAIT);
  }
}


/**
  * @brief  enable/disable HightPass filters ( DC remover )  for Voltage Channel (  V )
  * @param[in]   in_Metro_Device_Id (device ID), HOST or EXT1 to EXT4
  * @param[in]   METRO_internal_Channel_t (Channel ID), Channel 1 or 2 ( according to device )
  * @param[in]   in_Metro_CMD :   DEVICE_DISABLE = 0,  DEVICE_ENABLE = 1
  * @param[out]  None
  * @retval      None
  */
void Metro_HAL_Set_Voltage_HP_Filter(METRO_NB_Device_t in_Metro_Device_Id,METRO_internal_Channel_t in_Metro_int_Channel, METRO_CMD_Device_t in_Metro_CMD)
{

  if(in_Metro_Device_Id >= EXT1) 
  {
    if ( in_Metro_int_Channel == INT_CHANNEL_1)
    {
      /* Reset enable/disable Voltage HP Filter  bit */
      (p_Metro_Device_Config[in_Metro_Device_Id].metro_stpm_reg.DSPCTRL1) &= ~ BIT_MASK_STPM_VOLT_HPF_BYPASS; 
        
      /* set  new enable/disable Voltage HPF _Filter bit to RAM struct for EXT chip */
      (p_Metro_Device_Config[in_Metro_Device_Id].metro_stpm_reg.DSPCTRL1) |= (((uint32_t)in_Metro_CMD) << BIT_MASK_STPM_VOLT_HPF_BYPASS_SHIFT);
     }
     else if ( in_Metro_int_Channel == INT_CHANNEL_2)
     {
       /* Reset enable/disable Voltage HP_Filter bit */
       (p_Metro_Device_Config[in_Metro_Device_Id].metro_stpm_reg.DSPCTRL2) &= ~ BIT_MASK_STPM_VOLT_HPF_BYPASS; 
        
       /* set  new enable/disable Voltage HP_Filter bit to RAM struct for EXT chip */
       (p_Metro_Device_Config[in_Metro_Device_Id].metro_stpm_reg.DSPCTRL2) |= (((uint32_t)in_Metro_CMD) << BIT_MASK_STPM_VOLT_HPF_BYPASS_SHIFT);    
     }

     /* Now send data to the external chip */      
     /* Now Write the 2 U32 registers inside external chip  for DSPCR1 -> start address is DSPCR1 -> address = 0 */
    uint32_t addr = 0;
    Metro_HAL_Stpm_write(in_Metro_Device_Id,(uint8_t*)&addr,2,&p_Metro_Device_Config[in_Metro_Device_Id].metro_stpm_reg.DSPCTRL1,STPM_WAIT);
  }
}

/**
  * @brief      Get configs for HP filters for Current Channel requested
  * @param[in]   in_Metro_Device_Id (device ID), HOST or EXT1 to EXT4
  * @param[in]   METRO_internal_Channel_t (Channel ID), Channel 1 or 2 ( according to device )
  * @param[out]  None
  * @retval      Return METRO_CMD_Device_t :   DEVICE_DISABLE = 0,  DEVICE_ENABLE = 1
  */
METRO_CMD_Device_t Metro_HAL_Get_Current_HP_Filter(METRO_NB_Device_t in_Metro_Device_Id,METRO_internal_Channel_t in_Metro_int_Channel)
{
  METRO_CMD_Device_t CMD_Device = DEVICE_DISABLE;
  
  if(in_Metro_Device_Id >= EXT1) 
  {
    if ( in_Metro_int_Channel == INT_CHANNEL_1)
    {
      /* Get Current_HP_Filter Enable bit from EXT chip  */
      CMD_Device = (METRO_CMD_Device_t)(((p_Metro_Device_Config[in_Metro_Device_Id].metro_stpm_reg.DSPCTRL1)&BIT_MASK_STPM_CURR_HPF_BYPASS)>> BIT_MASK_STPM_CURR_HPF_BYPASS_SHIFT);   
    }
    else if ( in_Metro_int_Channel == INT_CHANNEL_2)
    {
      /* Get Current_HP_Filter Enable bit from EXT chip  */
      CMD_Device = (METRO_CMD_Device_t)(((p_Metro_Device_Config[in_Metro_Device_Id].metro_stpm_reg.DSPCTRL2)&BIT_MASK_STPM_CURR_HPF_BYPASS)>> BIT_MASK_STPM_CURR_HPF_BYPASS_SHIFT);   
    }
  }
  return (CMD_Device);  
}

/**
  * @brief      Get configs for HP filters for Voltage Channel requested
  * @param[in]   in_Metro_Device_Id (device ID), HOST or EXT1 to EXT4
  * @param[in]   METRO_internal_Channel_t (Channel ID), Channel 1 or 2 ( according to device )
  * @param[out]  None
  * @retval      Return METRO_CMD_Device_t :   DEVICE_DISABLE = 0,  DEVICE_ENABLE = 1
  */
METRO_CMD_Device_t Metro_HAL_Get_Voltage_HP_Filter(METRO_NB_Device_t in_Metro_Device_Id,METRO_internal_Channel_t in_Metro_int_Channel)
{
  METRO_CMD_Device_t CMD_Device = DEVICE_DISABLE;
  
  if(in_Metro_Device_Id >= EXT1) 
  {
    if ( in_Metro_int_Channel == INT_CHANNEL_1)
    {
      /* Get Voltage hP Filter Enable bit from EXT chip  */
      CMD_Device = (METRO_CMD_Device_t)(((p_Metro_Device_Config[in_Metro_Device_Id].metro_stpm_reg.DSPCTRL1)&BIT_MASK_STPM_VOLT_HPF_BYPASS)>> BIT_MASK_STPM_VOLT_HPF_BYPASS_SHIFT);   
    }
    else if ( in_Metro_int_Channel == INT_CHANNEL_2)
    {
      /* Get Voltage hP_Filter Enable bit from EXT chip  */
      CMD_Device = (METRO_CMD_Device_t)(((p_Metro_Device_Config[in_Metro_Device_Id].metro_stpm_reg.DSPCTRL2)&BIT_MASK_STPM_VOLT_HPF_BYPASS)>> BIT_MASK_STPM_VOLT_HPF_BYPASS_SHIFT);   
    }
  }
  return (CMD_Device);  
}

/**
  * @brief       Enable or disable Coil integrator (Rogowski) for a  channel 
  * @param[in]   in_Metro_Device_Id (device ID), HOST or EXT1 to EXT4
  * @param[in]   METRO_internal_Channel_t (Channel ID), Channel 1 or 2 ( according to device )
  * @param[in]   in_Metro_CMD :   DEVICE_DISABLE = 0,  DEVICE_ENABLE = 1
  * @param[out]  None
  * @retval      None
  */
void Metro_HAL_Set_Coil_integrator(METRO_NB_Device_t in_Metro_Device_Id,METRO_internal_Channel_t in_Metro_int_Channel, METRO_CMD_Device_t in_Metro_CMD)
{
  if(in_Metro_Device_Id >= EXT1) 
  {
    if ( in_Metro_int_Channel == INT_CHANNEL_1)
    {
    	metrology_platform_log(MET_LOG_INFO, "Metro_HAL_Set_Coil_integrator channel1");
      /* Reset enable/disable Coil_integrator bit */
      (p_Metro_Device_Config[in_Metro_Device_Id].metro_stpm_reg.DSPCTRL1) &= ~ BIT_MASK_STPM_CURR_ROGOWSKY_SEL; 
          
       /* set  new enable/disable Coil_integrator bit to RAM struct for EXT chip */
      (p_Metro_Device_Config[in_Metro_Device_Id].metro_stpm_reg.DSPCTRL1) |= (((uint32_t)in_Metro_CMD) << BIT_MASK_STPM_CURR_ROGOWSKY_SEL_SHIFT);
    }
    else  if( in_Metro_int_Channel == INT_CHANNEL_2)
    {
       /* Reset enable/disable Coil_integrator bit */
       (p_Metro_Device_Config[in_Metro_Device_Id].metro_stpm_reg.DSPCTRL2) &= ~ BIT_MASK_STPM_CURR_ROGOWSKY_SEL; 
          
       /* set  new enable/disable Coil_integrator bit to RAM struct for EXT chip */
       (p_Metro_Device_Config[in_Metro_Device_Id].metro_stpm_reg.DSPCTRL2) |= (((uint32_t)in_Metro_CMD) << BIT_MASK_STPM_CURR_ROGOWSKY_SEL_SHIFT);    
    }

    /* Now send data to the external chip */      
    /* Now Write the 2 U32 registers inside external chip  for DSPCR1 -> start address is DSPCR1 -> address = 0 */
    uint32_t addr = 0;
    Metro_HAL_Stpm_write(in_Metro_Device_Id,(uint8_t*)&addr,2,&p_Metro_Device_Config[in_Metro_Device_Id].metro_stpm_reg.DSPCTRL1,STPM_WAIT);
  }
}
/**
  * @brief      Get configs for Coil integrator Rogowski  for Channel requested
  * @param[in]   in_Metro_Device_Id (device ID), HOST or EXT1 to EXT4
  * @param[in]   METRO_internal_Channel_t (Channel ID), Channel 1 or 2 ( according to device )
  * @param[out]  None
  * @retval     Return METRO_CMD_Device_t :   DEVICE_DISABLE = 0,  DEVICE_ENABLE = 1,
  */
METRO_CMD_Device_t Metro_HAL_Get_Coil_integrator(METRO_NB_Device_t in_Metro_Device_Id,METRO_internal_Channel_t in_Metro_int_Channel)
{
  METRO_CMD_Device_t CMD_Device = DEVICE_DISABLE;
  
  if(in_Metro_Device_Id >= EXT1) 
  {
    if ( in_Metro_int_Channel == INT_CHANNEL_1)
    {
      /* Get Coil integrator Enable bit from EXT chip  */
      CMD_Device = (METRO_CMD_Device_t)(((p_Metro_Device_Config[in_Metro_Device_Id].metro_stpm_reg.DSPCTRL1)&BIT_MASK_STPM_CURR_ROGOWSKY_SEL)>> BIT_MASK_STPM_CURR_ROGOWSKY_SEL_SHIFT);   
    }
    else if ( in_Metro_int_Channel == INT_CHANNEL_2)
    {
      /* Get Coil integrator Enable bit from EXT chip  */
      CMD_Device = (METRO_CMD_Device_t)(((p_Metro_Device_Config[in_Metro_Device_Id].metro_stpm_reg.DSPCTRL2)&BIT_MASK_STPM_CURR_ROGOWSKY_SEL)>> BIT_MASK_STPM_CURR_ROGOWSKY_SEL_SHIFT);   
    }
  }
  return (CMD_Device);     
}

/**
  * @brief       Get Ah Accumulation Down Threshold  for Channel requested
  * @param[in]   in_Metro_Device_Id (device ID), HOST or EXT1 to EXT4
  * @param[in]   METRO_internal_Channel_t (Channel ID), Channel 1 or 2 ( according to device )
  * @param[out]  None
  * @retval     Return u16 :   Ah Accumulation Down Threshold
  */
uint16_t Metro_HAL_Get_Ah_Accumulation_Down_Threshold(METRO_NB_Device_t in_Metro_Device_Id,METRO_internal_Channel_t in_Metro_int_Channel)
{
  uint16_t Ah_Accumulation_Down_Threshold=0;
  
  if(in_Metro_Device_Id >= EXT1) 
  {
    if ( in_Metro_int_Channel == INT_CHANNEL_1)
    {
      /* Get Ah Accumulation Down Threshold from EXT chip  */
      Ah_Accumulation_Down_Threshold = (uint16_t)((p_Metro_Device_Config[in_Metro_Device_Id].metro_stpm_reg.DSPCTRL10)&BIT_MASK_STPM_RMS1_VALUE_MIN);   
    }
    else if ( in_Metro_int_Channel == INT_CHANNEL_2)
    {
      /* Get Ah Accumulation Down Threshold EXT chip  */
      Ah_Accumulation_Down_Threshold = (uint16_t)((p_Metro_Device_Config[in_Metro_Device_Id].metro_stpm_reg.DSPCTRL12)&BIT_MASK_STPM_RMS2_VALUE_MIN);   
    }
  }
  return (Ah_Accumulation_Down_Threshold);   
}


/**
  * @brief       Get Ah Accumulation Up Threshold  for Channel requested
  * @param[in]   in_Metro_Device_Id (device ID), HOST or EXT1 to EXT4
  * @param[in]   METRO_internal_Channel_t (Channel ID), Channel 1 or 2 ( according to device )
  * @param[out]  None
  * @retval     Return u16 :   Ah Accumulation Up Threshold
  */
uint16_t Metro_HAL_Get_Ah_Accumulation_Up_Threshold(METRO_NB_Device_t in_Metro_Device_Id,METRO_internal_Channel_t in_Metro_int_Channel)
{
  uint16_t Ah_Accumulation_Up_Threshold=0;
  
  if(in_Metro_Device_Id >= EXT1) 
  {
    if ( in_Metro_int_Channel == INT_CHANNEL_1)
    {
      /* Get Ah Accumulation Up Threshold from EXT chip  */
      Ah_Accumulation_Up_Threshold = (uint16_t)((p_Metro_Device_Config[in_Metro_Device_Id].metro_stpm_reg.DSPCTRL9)&BIT_MASK_STPM_RMS1_VALUE_MAX);   
    }
    else if ( in_Metro_int_Channel == INT_CHANNEL_2)
    {
      /* Get Ah Accumulation Up Threshold EXT chip  */
      Ah_Accumulation_Up_Threshold = (uint16_t)((p_Metro_Device_Config[in_Metro_Device_Id].metro_stpm_reg.DSPCTRL11)&BIT_MASK_STPM_RMS2_VALUE_MAX);   
    }
  }
  return (Ah_Accumulation_Up_Threshold);     
}


/**
  * @brief       Set Ah Accumulation Down Threshold for a  channel 
  * @param[in]   in_Metro_Device_Id (device ID), HOST or EXT1 to EXT4
  * @param[in]   METRO_internal_Channel_t (Channel ID), Channel 1 or 2 ( according to device )
  * @param[in]   u16 :   Ah Accumulation Down Threshold
  * @param[out]  None
  * @retval      None
  */
void Metro_HAL_Set_Ah_Accumulation_Down_Threshold(METRO_NB_Device_t in_Metro_Device_Id,METRO_internal_Channel_t in_Metro_int_Channel,uint16_t in_Metro_Ah_Down_Threshold)
{
  uint32_t tmp_addr =0;
  
  if(in_Metro_Device_Id >= EXT1) 
  {
    if ( in_Metro_int_Channel == INT_CHANNEL_1)
    {
      /* Reset Ah_Accumulation_Down_Threshold */
      (p_Metro_Device_Config[in_Metro_Device_Id].metro_stpm_reg.DSPCTRL10) &= ~ BIT_MASK_STPM_RMS1_VALUE_MIN; 
        
      /* set  Ah_Accumulation_Down_Threshold to RAM struct for EXT chip */
      (p_Metro_Device_Config[in_Metro_Device_Id].metro_stpm_reg.DSPCTRL10) |= ((uint32_t)in_Metro_Ah_Down_Threshold);
     }
     else  if( in_Metro_int_Channel == INT_CHANNEL_2)
     {
       /* Reset Ah_Accumulation_Down_Threshold */
       (p_Metro_Device_Config[in_Metro_Device_Id].metro_stpm_reg.DSPCTRL12) &= ~ BIT_MASK_STPM_RMS2_VALUE_MIN; 
        
       /* set  Ah_Accumulation_Down_Threshold to RAM struct for EXT chip */
       (p_Metro_Device_Config[in_Metro_Device_Id].metro_stpm_reg.DSPCTRL12) |= ((uint32_t)in_Metro_Ah_Down_Threshold);
     }

     /* Now send data to the external chip */
     /* Calculate the base address to read inisde STPM chip  */
     /* the offset should be provided in 2 bytes format (16 bits by 16 bits) for STPM */
     tmp_addr = (uint32_t)((uint8_t*)&p_Metro_Device_Config[in_Metro_Device_Id].metro_stpm_reg.DSPCTRL9 - (uint8_t*)&p_Metro_Device_Config[in_Metro_Device_Id].metro_stpm_reg.DSPCTRL1)/2;
            
            
     /* Now send data to the external chip */      
     /* Now Write the 4 U32 registers inside external chip  for DSPCR9 to 12 -> start address is DSPCR10 adress */
     Metro_HAL_Stpm_write(in_Metro_Device_Id,(uint8_t*)&tmp_addr,4,&p_Metro_Device_Config[in_Metro_Device_Id].metro_stpm_reg.DSPCTRL9,STPM_WAIT);

  }
}
/**
  * @brief       Set Ah Accumulation Up Threshold for a  channel 
  * @param[in]   in_Metro_Device_Id (device ID), HOST or EXT1 to EXT4
  * @param[in]   METRO_internal_Channel_t (Channel ID), Channel 1 or 2 ( according to device )
  * @param[in]   u16 :   Ah Accumulation Up Threshold
  * @param[out]  None
  * @retval      None
  */
void Metro_HAL_Set_Ah_Accumulation_Up_Threshold(METRO_NB_Device_t in_Metro_Device_Id,METRO_internal_Channel_t in_Metro_int_Channel,uint16_t in_Metro_Ah_Up_Threshold)
{
  uint32_t tmp_addr =0;
  
  if(in_Metro_Device_Id >= EXT1) 
  {
    if ( in_Metro_int_Channel == INT_CHANNEL_1)
    {
      /* Reset Ah Accumulation Up Threshold */
      (p_Metro_Device_Config[in_Metro_Device_Id].metro_stpm_reg.DSPCTRL9) &= ~ BIT_MASK_STPM_RMS1_VALUE_MAX; 
        
      /* set  Ah Accumulation Up Threshold to RAM struct for EXT chip */
      (p_Metro_Device_Config[in_Metro_Device_Id].metro_stpm_reg.DSPCTRL9) |= ((uint32_t)in_Metro_Ah_Up_Threshold);
     }
     else  if( in_Metro_int_Channel == INT_CHANNEL_2)
     {
       /* Reset Ah Accumulation Up Threshold */
       (p_Metro_Device_Config[in_Metro_Device_Id].metro_stpm_reg.DSPCTRL11) &= ~ BIT_MASK_STPM_RMS2_VALUE_MAX; 
        
       /* set  Ah Accumulation Up Threshold to RAM struct for EXT chip */
       (p_Metro_Device_Config[in_Metro_Device_Id].metro_stpm_reg.DSPCTRL11) |= ((uint32_t)in_Metro_Ah_Up_Threshold);
     }

     /* Now send data to the external chip */
     /* Calculate the base address to read inisde STPM chip  */
     /* the offset should be provided in 2 bytes format (16 bits by 16 bits) for STPM */
     tmp_addr = (uint32_t)((uint8_t*)&p_Metro_Device_Config[in_Metro_Device_Id].metro_stpm_reg.DSPCTRL9 - (uint8_t*)&p_Metro_Device_Config[in_Metro_Device_Id].metro_stpm_reg.DSPCTRL1)/2;
            
     /* Now send data to the external chip */      
     /* Now Write the 4 U32 registers inside external chip  for DSPCR9 to 12 -> start address is DSPCR10 adress */
     Metro_HAL_Stpm_write(in_Metro_Device_Id,(uint8_t*)&tmp_addr,4,&p_Metro_Device_Config[in_Metro_Device_Id].metro_stpm_reg.DSPCTRL9,STPM_WAIT);
  }
}
/**
  * @brief       Set Power Offset Compensation from a channel and device
  * @param[in]   in_Metro_Device_Id (device ID), HOST or EXT1 to EXT4
  * @param[in]   METRO_internal_Channel_t (Channel ID), Channel 1 or 2 ( according to device )
  * @param[in]   METRO_Power_selection_t in_Metro_Power_Selection : W_ACTIVE, F_ACTIVE, REACTIVE, APPARENT_RMS 
  * @param[in]   s16 in_Metro_Power_Offset
* @retval      None
  */
void Metro_HAL_Set_Power_Offset_Compensation(METRO_NB_Device_t in_Metro_Device_Id,METRO_internal_Channel_t in_Metro_int_Channel,METRO_Power_selection_t in_Metro_Power_Selection, int16_t in_Metro_Power_Offset)
{
  uint32_t tmp_addr =0;
  
  if(in_Metro_Device_Id >= EXT1) 
  {
    switch (in_Metro_Power_Selection)
    {
      case (W_ACTIVE):
      {
        if ( in_Metro_int_Channel == INT_CHANNEL_1)
        {  
          /* Reset Power Offset Compensation value  (COMET) */
          p_Metro_Device_Config[in_Metro_Device_Id].metro_stpm_reg.DSPCTRL9 &= ~ BIT_MASK_STPM_OFFSET_A1;
            
          /* Set Power Offset Compensation from EXT chip  */
          (p_Metro_Device_Config[in_Metro_Device_Id].metro_stpm_reg.DSPCTRL9) |= (((uint32_t)(in_Metro_Power_Offset)<<BIT_MASK_STPM_OFFSET_A_SHIFT)& BIT_MASK_STPM_OFFSET_A1); 
        }
        else if ( in_Metro_int_Channel == INT_CHANNEL_2)
        {
          /* Reset Power Offset Compensation value  (COMET) */
          p_Metro_Device_Config[in_Metro_Device_Id].metro_stpm_reg.DSPCTRL11 &= ~ BIT_MASK_STPM_OFFSET_A2;
            
          /* Set Power Offset Compensation from EXT chip  */
          (p_Metro_Device_Config[in_Metro_Device_Id].metro_stpm_reg.DSPCTRL11) |= (((uint32_t)(in_Metro_Power_Offset)<<BIT_MASK_STPM_OFFSET_A_SHIFT)& BIT_MASK_STPM_OFFSET_A2); 
        }
          
        /* Now send data to the external chip */
        /* Calculate the base address to read inisde STPM chip  */
        /* the offset should be provided in 2 bytes format (16 bits by 16 bits) for STPM */
        tmp_addr = (uint32_t)((uint8_t*)&p_Metro_Device_Config[in_Metro_Device_Id].metro_stpm_reg.DSPCTRL9 - (uint8_t*)&p_Metro_Device_Config[in_Metro_Device_Id].metro_stpm_reg.DSPCTRL1)/2;
                
                
        /* Now send data to the external chip */      
        /* Now Write the 4 U32 registers inside external chip  for DSPCR9 to 12 -> start address is DSPCR10 adress */
        Metro_HAL_Stpm_write(in_Metro_Device_Id,(uint8_t*)&tmp_addr,4,&p_Metro_Device_Config[in_Metro_Device_Id].metro_stpm_reg.DSPCTRL9,STPM_WAIT);
      }
      break;
      case (F_ACTIVE):
      {
        if ( in_Metro_int_Channel == INT_CHANNEL_1)
        {
          /* Reset Power Offset Compensation value  (COMET) */
          p_Metro_Device_Config[in_Metro_Device_Id].metro_stpm_reg.DSPCTRL9 &= ~ BIT_MASK_STPM_OFFSET_AF1;
            
          /* Set Power Offset Compensation from EXT chip  */
          (p_Metro_Device_Config[in_Metro_Device_Id].metro_stpm_reg.DSPCTRL9) |= (((uint32_t)(in_Metro_Power_Offset)<<BIT_MASK_STPM_OFFSET_AF_SHIFT)& BIT_MASK_STPM_OFFSET_AF1); 
        }
        else if ( in_Metro_int_Channel == INT_CHANNEL_2)
        {
          /* Reset Power Offset Compensation value  (COMET) */
          p_Metro_Device_Config[in_Metro_Device_Id].metro_stpm_reg.DSPCTRL11 &= ~ BIT_MASK_STPM_OFFSET_AF2;
            
          /* Set Power Offset Compensation from EXT chip  */
          (p_Metro_Device_Config[in_Metro_Device_Id].metro_stpm_reg.DSPCTRL11) |= (((uint32_t)(in_Metro_Power_Offset)<<BIT_MASK_STPM_OFFSET_AF_SHIFT)& BIT_MASK_STPM_OFFSET_AF2); 
        }
          
        /* Now send data to the external chip */
        /* Calculate the base address to read inisde STPM chip  */
        /* the offset should be provided in 2 bytes format (16 bits by 16 bits) for STPM */
        tmp_addr = (uint32_t)((uint8_t*)&p_Metro_Device_Config[in_Metro_Device_Id].metro_stpm_reg.DSPCTRL9 - (uint8_t*)&p_Metro_Device_Config[in_Metro_Device_Id].metro_stpm_reg.DSPCTRL1)/2;
                
        /* Now send data to the external chip */      
        /* Now Write the 4 U32 registers inside external chip  for DSPCR9 to 12 -> start address is DSPCR10 adress */
        Metro_HAL_Stpm_write(in_Metro_Device_Id,(uint8_t*)&tmp_addr,4,&p_Metro_Device_Config[in_Metro_Device_Id].metro_stpm_reg.DSPCTRL9,STPM_WAIT);

      }
      break;
      case (REACTIVE):
      {
        if ( in_Metro_int_Channel == INT_CHANNEL_1)
        {
          /* Reset Power Offset Compensation value  (COMET) */
          p_Metro_Device_Config[in_Metro_Device_Id].metro_stpm_reg.DSPCTRL10 &= ~ BIT_MASK_STPM_OFFSET_R1;
            
          /* Set Power Offset Compensation from EXT chip  */
          (p_Metro_Device_Config[in_Metro_Device_Id].metro_stpm_reg.DSPCTRL10) |= (((uint32_t)(in_Metro_Power_Offset)<<BIT_MASK_STPM_OFFSET_R_SHIFT)& BIT_MASK_STPM_OFFSET_R1); 
        }
        else if ( in_Metro_int_Channel == INT_CHANNEL_2)
        {
          /* Reset Power Offset Compensation value  (COMET) */
          p_Metro_Device_Config[in_Metro_Device_Id].metro_stpm_reg.DSPCTRL12 &= ~ BIT_MASK_STPM_OFFSET_R2;
            
          /* Set Power Offset Compensation from EXT chip  */
          (p_Metro_Device_Config[in_Metro_Device_Id].metro_stpm_reg.DSPCTRL12) |= (((uint32_t)(in_Metro_Power_Offset)<<BIT_MASK_STPM_OFFSET_R_SHIFT)& BIT_MASK_STPM_OFFSET_R2); 
        }
          
        /* Now send data to the external chip */
        /* Calculate the base address to read inisde STPM chip  */
        /* the offset should be provided in 2 bytes format (16 bits by 16 bits) for STPM */
        tmp_addr = (uint32_t)((uint8_t*)&p_Metro_Device_Config[in_Metro_Device_Id].metro_stpm_reg.DSPCTRL9 - (uint8_t*)&p_Metro_Device_Config[in_Metro_Device_Id].metro_stpm_reg.DSPCTRL1)/2;
                
        /* Now send data to the external chip */      
        /* Now Write the 4 U32 registers inside external chip  for DSPCR9 to 12 -> start address is DSPCR10 adress */
        Metro_HAL_Stpm_write(in_Metro_Device_Id,(uint8_t*)&tmp_addr,4,&p_Metro_Device_Config[in_Metro_Device_Id].metro_stpm_reg.DSPCTRL9,STPM_WAIT);

      }
      break;
      case (APPARENT_RMS):
      {
        if ( in_Metro_int_Channel == INT_CHANNEL_1)
        {
          /* Reset Power Offset Compensation value  (COMET) */
          p_Metro_Device_Config[in_Metro_Device_Id].metro_stpm_reg.DSPCTRL10 &= ~ BIT_MASK_STPM_OFFSET_S1;
            
          /* Set Power Offset Compensation from EXT chip  */
          (p_Metro_Device_Config[in_Metro_Device_Id].metro_stpm_reg.DSPCTRL10) |= (((uint32_t)(in_Metro_Power_Offset)<<BIT_MASK_STPM_OFFSET_S_SHIFT)& BIT_MASK_STPM_OFFSET_S1); 
        }
        else if ( in_Metro_int_Channel == INT_CHANNEL_2)
        {
          /* Reset Power Offset Compensation value  (COMET) */
          p_Metro_Device_Config[in_Metro_Device_Id].metro_stpm_reg.DSPCTRL12 &= ~ BIT_MASK_STPM_OFFSET_S2;
            
          /* Set Power Offset Compensation from EXT chip  */
          (p_Metro_Device_Config[in_Metro_Device_Id].metro_stpm_reg.DSPCTRL12) |= (((uint32_t)(in_Metro_Power_Offset)<<BIT_MASK_STPM_OFFSET_S_SHIFT)& BIT_MASK_STPM_OFFSET_S2); 
        }
          
        /* Now send data to the external chip */
        /* Calculate the base address to read inisde STPM chip  */
        /* the offset should be provided in 2 bytes format (16 bits by 16 bits) for STPM */
        tmp_addr = (uint32_t)((uint8_t*)&p_Metro_Device_Config[in_Metro_Device_Id].metro_stpm_reg.DSPCTRL9 - (uint8_t*)&p_Metro_Device_Config[in_Metro_Device_Id].metro_stpm_reg.DSPCTRL1)/2;
                       
        /* Now send data to the external chip */      
        /* Now Write the 4 U32 registers inside external chip  for DSPCR9 to 12 -> start address is DSPCR10 adress */
        Metro_HAL_Stpm_write(in_Metro_Device_Id,(uint8_t*)&tmp_addr,4,&p_Metro_Device_Config[in_Metro_Device_Id].metro_stpm_reg.DSPCTRL9,STPM_WAIT);

      }
      break;    

    }
  }   
}

/**
  * @brief       Get Power Offset Compensation from a channel and device
  * @param[in]   in_Metro_Device_Id (device ID), HOST or EXT1 to EXT4
  * @param[in]   METRO_internal_Channel_t (Channel ID), Channel 1 or 2 ( according to device )
  * @param[in]  METRO_Power_selection_t in_Metro_Power_Selection : W_ACTIVE, F_ACTIVE, REACTIVE, APPARENT_RMS 
  * @retval     Return s16 :   Power_Offset_Compensation
  */
int16_t Metro_HAL_Get_Power_Offset_Compensation(METRO_NB_Device_t in_Metro_Device_Id,METRO_internal_Channel_t in_Metro_int_Channel,METRO_Power_selection_t in_Metro_Power_Selection)
{
  int16_t Power_Offset_Compensation=0;
  
  if(in_Metro_Device_Id >= EXT1) 
  {
    switch (in_Metro_Power_Selection)
    {
      case (W_ACTIVE):
      {
        if ( in_Metro_int_Channel == INT_CHANNEL_1)
        {
          /* Get Power Offset Compensation from EXT chip  */
          Power_Offset_Compensation = (int16_t)(((p_Metro_Device_Config[in_Metro_Device_Id].metro_stpm_reg.DSPCTRL9)&BIT_MASK_STPM_OFFSET_A1) >> BIT_MASK_STPM_OFFSET_A_SHIFT) ;   
        }
        else if ( in_Metro_int_Channel == INT_CHANNEL_2)
        {
          /* Get Power Offset Compensation EXT chip  */
          Power_Offset_Compensation = (int16_t)(((p_Metro_Device_Config[in_Metro_Device_Id].metro_stpm_reg.DSPCTRL11)&BIT_MASK_STPM_OFFSET_A2) >> BIT_MASK_STPM_OFFSET_A_SHIFT) ;   
        }
      }
      break;
      case (F_ACTIVE):
      {
        if ( in_Metro_int_Channel == INT_CHANNEL_1)
        {
          /* Get Power Offset Compensation from EXT chip  */
          Power_Offset_Compensation = (int16_t)(((p_Metro_Device_Config[in_Metro_Device_Id].metro_stpm_reg.DSPCTRL9)&BIT_MASK_STPM_OFFSET_AF1) >> BIT_MASK_STPM_OFFSET_AF_SHIFT) ;   
        }
        else if ( in_Metro_int_Channel == INT_CHANNEL_2)
        {
          /* Get Power Offset Compensation EXT chip  */
          Power_Offset_Compensation = (int16_t)(((p_Metro_Device_Config[in_Metro_Device_Id].metro_stpm_reg.DSPCTRL11)&BIT_MASK_STPM_OFFSET_AF2) >> BIT_MASK_STPM_OFFSET_AF_SHIFT) ;   
        }
      }
      break;
      case (REACTIVE):
      {
        if ( in_Metro_int_Channel == INT_CHANNEL_1)
        {
          /* Get Power Offset Compensation from EXT chip  */
          Power_Offset_Compensation = (int16_t)(((p_Metro_Device_Config[in_Metro_Device_Id].metro_stpm_reg.DSPCTRL10)&BIT_MASK_STPM_OFFSET_R1) >> BIT_MASK_STPM_OFFSET_R_SHIFT) ;   
        }
        else if ( in_Metro_int_Channel == INT_CHANNEL_2)
        {
          /* Get Power Offset Compensation EXT chip  */
          Power_Offset_Compensation = (int16_t)(((p_Metro_Device_Config[in_Metro_Device_Id].metro_stpm_reg.DSPCTRL12)&BIT_MASK_STPM_OFFSET_R2) >> BIT_MASK_STPM_OFFSET_R_SHIFT) ;   
        }
      }
      break;
      case (APPARENT_RMS):
      {
        if ( in_Metro_int_Channel == INT_CHANNEL_1)
        {
          /* Get Power Offset Compensation from EXT chip  */
          Power_Offset_Compensation = (int16_t)(((p_Metro_Device_Config[in_Metro_Device_Id].metro_stpm_reg.DSPCTRL10)&BIT_MASK_STPM_OFFSET_S1) >> BIT_MASK_STPM_OFFSET_S_SHIFT) ;   
        }
        else if ( in_Metro_int_Channel == INT_CHANNEL_2)
        {
          /* Get Power Offset Compensation EXT chip  */
          Power_Offset_Compensation = (int16_t)(((p_Metro_Device_Config[in_Metro_Device_Id].metro_stpm_reg.DSPCTRL12)&BIT_MASK_STPM_OFFSET_S2) >> BIT_MASK_STPM_OFFSET_S_SHIFT) ;   
        }
      }
      break;    

    }
   
    /* The return Metro_Power_Offset is in 16 signed */
    /* depending of device, the internal regisers are under 9 bits ( for COMET or STMET) and 10 bits (For STPM) in Two's cpomplemented format */
    /* So put the value in good format before to return it inside registers */
    
    /* Detect if the value is negative inside register   -> MSB of 10 bit = 1*/
    if ((Power_Offset_Compensation & BIT_MASK_STPM_POWER_SIGN) > 0)
    {
      /* now convert value in 10 bits two's Complemented format to S16 format */
      Power_Offset_Compensation |= 0xFC00;
    }
  }
  return (Power_Offset_Compensation);   
}

/**
  * @brief       Set V Calibration for a  channel 
  * @param[in]   in_Metro_Device_Id (device ID), HOST or EXT1 to EXT4
  * @param[in]   METRO_internal_Channel_t (Channel ID), Channel 1 or 2 ( according to device )
  * @param[in]   u16 in_Metro_V_calibrator_value
  * @param[out]  None
  * @retval      None
  */
void Metro_HAL_Set_V_Calibration(METRO_NB_Device_t in_Metro_Device_Id,METRO_internal_Channel_t in_Metro_int_Channel, uint16_t in_Metro_V_calibrator_value)
{
  uint32_t tmp_addr =0;

  if(in_Metro_Device_Id >= EXT1) 
  {
    if ( in_Metro_int_Channel == INT_CHANNEL_1)
    {
      /* Reset  V Calibration value bits */
      (p_Metro_Device_Config[in_Metro_Device_Id].metro_stpm_reg.DSPCTRL5) &= ~ BIT_MASK_STPM_CAL_V1; 
        
      /* Set new V Calibration value to RAM struct for EXT chip */
      (p_Metro_Device_Config[in_Metro_Device_Id].metro_stpm_reg.DSPCTRL5) |= ((in_Metro_V_calibrator_value)& BIT_MASK_STPM_CAL_V1);
    }
    else  if( in_Metro_int_Channel == INT_CHANNEL_2)
    {
      /* Reset  V Calibration value bits */
      (p_Metro_Device_Config[in_Metro_Device_Id].metro_stpm_reg.DSPCTRL7) &= ~ BIT_MASK_STPM_CAL_V2; 
        
      /* Set new V Calibration value to RAM struct for EXT chip */
      (p_Metro_Device_Config[in_Metro_Device_Id].metro_stpm_reg.DSPCTRL7) |= ((in_Metro_V_calibrator_value)& BIT_MASK_STPM_CAL_V2);
    }

    /* Now send data to the external chip */
    /* Calculate the base address to read inisde STPM chip  */
    /* the offset should be provided in 2 bytes format (16 bits by 16 bits) for STPM */
    tmp_addr = (uint32_t)((uint8_t*)&p_Metro_Device_Config[in_Metro_Device_Id].metro_stpm_reg.DSPCTRL5 - (uint8_t*)&p_Metro_Device_Config[in_Metro_Device_Id].metro_stpm_reg.DSPCTRL1)/2;
       
    /* Now Write the 3 U32 registers inside external chip  for DSPCR5 to 7  */
    Metro_HAL_Stpm_write(in_Metro_Device_Id,(uint8_t*)&tmp_addr,3,&p_Metro_Device_Config[in_Metro_Device_Id].metro_stpm_reg.DSPCTRL5,STPM_WAIT);

  }
}
/**
  * @brief       Get V Calibration  for Channel requested
  * @param[in]   in_Metro_Device_Id (device ID), HOST or EXT1 to EXT4
  * @param[in]   METRO_internal_Channel_t (Channel ID), Channel 1 or 2 ( according to device )
  * @param[out]  None
  * @retval     Return in_Metro_V_calibrator_value
  */
uint16_t Metro_HAL_Get_V_Calibration(METRO_NB_Device_t in_Metro_Device_Id,METRO_internal_Channel_t in_Metro_int_Channel)
{
  uint16_t  V_calibrator_value = 0;
  
  if(in_Metro_Device_Id >= EXT1) 
  {
    if ( in_Metro_int_Channel == INT_CHANNEL_1)
    {    
      /* Get  V Calibration value from RAM struct for EXT chip */
      V_calibrator_value = (p_Metro_Device_Config[in_Metro_Device_Id].metro_stpm_reg.DSPCTRL5)&BIT_MASK_STPM_CAL_V1;
    }
    else  if( in_Metro_int_Channel == INT_CHANNEL_2)
    {     
      /* Get V Calibration value from RAM struct for EXT chip */
      V_calibrator_value = (p_Metro_Device_Config[in_Metro_Device_Id].metro_stpm_reg.DSPCTRL7)&BIT_MASK_STPM_CAL_V2;
    }
  }
  return V_calibrator_value;
}

/**
  * @brief       Set C Calibration for a  channel 
  * @param[in]   in_Metro_Device_Id (device ID), HOST or EXT1 to EXT4
  * @param[in]   METRO_internal_Channel_t (Channel ID), Channel 1 or 2 ( according to device )
  * @param[in]   u16 in_Metro_C_calibrator_value
  * @param[out]  None
  * @retval      None
  */
void Metro_HAL_Set_C_Calibration(METRO_NB_Device_t in_Metro_Device_Id,METRO_internal_Channel_t in_Metro_int_Channel, uint16_t in_Metro_C_calibrator_value)
{
  uint32_t tmp_addr =0;
    
  if(in_Metro_Device_Id >= EXT1) 
  {
    if ( in_Metro_int_Channel == INT_CHANNEL_1)
    {
      /* Reset  C Calibration value bits */
      (p_Metro_Device_Config[in_Metro_Device_Id].metro_stpm_reg.DSPCTRL6) &= ~ BIT_MASK_STPM_CAL_C1; 
        
      /* Set new C Calibration value to RAM struct for EXT chip */
      (p_Metro_Device_Config[in_Metro_Device_Id].metro_stpm_reg.DSPCTRL6) |= ((in_Metro_C_calibrator_value)& BIT_MASK_STPM_CAL_C1);
     }
     else  if( in_Metro_int_Channel == INT_CHANNEL_2)
     {
       /* Reset  C Calibration value bits */
       (p_Metro_Device_Config[in_Metro_Device_Id].metro_stpm_reg.DSPCTRL8) &= ~ BIT_MASK_STPM_CAL_C2; 
        
       /* Set new C Calibration value to RAM struct for EXT chip */
       (p_Metro_Device_Config[in_Metro_Device_Id].metro_stpm_reg.DSPCTRL8) |= ((in_Metro_C_calibrator_value)& BIT_MASK_STPM_CAL_C2);
     }

     /* Now send data to the external chip */
     /* Calculate the base address to read inisde STPM chip  */
     /* the offset should be provided in 2 bytes format (16 bits by 16 bits) for STPM */
     tmp_addr = (uint32_t)((uint8_t*)&p_Metro_Device_Config[in_Metro_Device_Id].metro_stpm_reg.DSPCTRL6 - (uint8_t*)&p_Metro_Device_Config[in_Metro_Device_Id].metro_stpm_reg.DSPCTRL1)/2;
       
     /* Now Write the 3 U32 registers inside external chip  for DSPCR6 to 8  */
     Metro_HAL_Stpm_write(in_Metro_Device_Id,(uint8_t*)&tmp_addr,3,&p_Metro_Device_Config[in_Metro_Device_Id].metro_stpm_reg.DSPCTRL6,STPM_WAIT);  
  }
}

/**
  * @brief       Get  C Calibration for Channel requested
  * @param[in]   in_Metro_Device_Id (device ID), HOST or EXT1 to EXT4
  * @param[in]   METRO_internal_Channel_t (Channel ID), Channel 1 or 2 ( according to device )
  * @param[out]  None
  * @retval     Return in_Metro_C_calibrator_value
  */
uint16_t Metro_HAL_Get_C_Calibration(METRO_NB_Device_t in_Metro_Device_Id,METRO_internal_Channel_t in_Metro_int_Channel)
{
  uint16_t C_calibrator_value =0;
    
  if(in_Metro_Device_Id >= EXT1) 
  {
    if ( in_Metro_int_Channel == INT_CHANNEL_1)
    {     
       /* Get C Calibration value from RAM struct for EXT chip */
       C_calibrator_value = (p_Metro_Device_Config[in_Metro_Device_Id].metro_stpm_reg.DSPCTRL6) & BIT_MASK_STPM_CAL_C1;
    }
    else  if( in_Metro_int_Channel == INT_CHANNEL_2)
    {      
       /* Get  C Calibration value from RAM struct for EXT chip */
       C_calibrator_value = (p_Metro_Device_Config[in_Metro_Device_Id].metro_stpm_reg.DSPCTRL8) &BIT_MASK_STPM_CAL_C2;
    }
  }
  return C_calibrator_value;
}

/**
  * @brief       Set Phase V Calibration for a  channel 
  * @param[in]   in_Metro_Device_Id (device ID), HOST or EXT1 to EXT4
  * @param[in]   METRO_internal_Channel_t (Channel ID), Channel 1 or 2 ( according to device )
  * @param[in]   u8 in_Metro_Phase_V_calibrator_value
  * @param[out]  None
  * @retval      None
  */
void Metro_HAL_Set_Phase_V_Calibration(METRO_NB_Device_t in_Metro_Device_Id,METRO_internal_Channel_t in_Metro_int_Channel, uint8_t in_Metro_Phase_V_calibrator_value)
{
   uint32_t tmp_addr =0;
    
  if(in_Metro_Device_Id >= EXT1) 
  {
     if ( in_Metro_int_Channel == INT_CHANNEL_1)
     {
        /* Reset  Phase V Calibration value bits */
        (p_Metro_Device_Config[in_Metro_Device_Id].metro_stpm_reg.DSPCTRL4) &= ~ BIT_MASK_STPM_PHASE_SHIFT_V1; 
        
        /* Set new Phase V Calibration value to RAM struct for EXT chip */
        (p_Metro_Device_Config[in_Metro_Device_Id].metro_stpm_reg.DSPCTRL4) |= (((uint32_t)(in_Metro_Phase_V_calibrator_value)<<BIT_MASK_STPM_PHASE_SHIFT_V1_SHIFT)& BIT_MASK_STPM_PHASE_SHIFT_V1);
     }
     else  if( in_Metro_int_Channel == INT_CHANNEL_2)
     {
         /* Reset Phase V Calibration value bits */
         (p_Metro_Device_Config[in_Metro_Device_Id].metro_stpm_reg.DSPCTRL4) &= ~ BIT_MASK_STPM_PHASE_SHIFT_V2; 
        
         /* Set new Phase V Calibration value to RAM struct for EXT chip */
         (p_Metro_Device_Config[in_Metro_Device_Id].metro_stpm_reg.DSPCTRL4) |= (((uint32_t)(in_Metro_Phase_V_calibrator_value)<<BIT_MASK_STPM_PHASE_SHIFT_V2_SHIFT)& BIT_MASK_STPM_PHASE_SHIFT_V2);
     }

      /* Now send data to the external chip */
      /* Calculate the base address to read inisde STPM chip  */
      /* the offset should be provided in 2 bytes format (16 bits by 16 bits) for STPM */
      tmp_addr = (uint32_t)((uint8_t*)&p_Metro_Device_Config[in_Metro_Device_Id].metro_stpm_reg.DSPCTRL4 - (uint8_t*)&p_Metro_Device_Config[in_Metro_Device_Id].metro_stpm_reg.DSPCTRL1)/2;
       
      /* Now Write the 1 U32 register inside external chip  for DSPCR4  */
      Metro_HAL_Stpm_write(in_Metro_Device_Id,(uint8_t*)&tmp_addr,1,&p_Metro_Device_Config[in_Metro_Device_Id].metro_stpm_reg.DSPCTRL4,STPM_WAIT);

  }
}
/**
  * @brief      Get Phase V Calibration  for Channel requested
  * @param[in]   in_Metro_Device_Id (device ID), HOST or EXT1 to EXT4
  * @param[in]   METRO_internal_Channel_t (Channel ID), Channel 1 or 2 ( according to device )
  * @param[out]  None
  * @retval     Return in_Metro_Phase_V_calibrator_value
  */
uint8_t Metro_HAL_Get_Phase_V_Calibration(METRO_NB_Device_t in_Metro_Device_Id,METRO_internal_Channel_t in_Metro_int_Channel)
{
  uint16_t  Phase_V_calibrator_value =0;
    
  if(in_Metro_Device_Id >= EXT1) 
  {
    if ( in_Metro_int_Channel == INT_CHANNEL_1)
    {     
       /* Get  Phase V Calibration value from RAM struct for EXT chip */
       Phase_V_calibrator_value = ((p_Metro_Device_Config[in_Metro_Device_Id].metro_stpm_reg.DSPCTRL4) & BIT_MASK_STPM_PHASE_SHIFT_V1) >>  BIT_MASK_STPM_PHASE_SHIFT_V1_SHIFT;
    }
    else  if( in_Metro_int_Channel == INT_CHANNEL_2)
    {     
       /* Get  Phase V Calibration value from RAM struct for EXT chip */
       Phase_V_calibrator_value = ((p_Metro_Device_Config[in_Metro_Device_Id].metro_stpm_reg.DSPCTRL4) & BIT_MASK_STPM_PHASE_SHIFT_V2) >>  BIT_MASK_STPM_PHASE_SHIFT_V2_SHIFT;
    }
  }
  return Phase_V_calibrator_value;
}

/**
  * @brief       Set Phase C Calibration for a  channel 
  * @param[in]   in_Metro_Device_Id (device ID), HOST or EXT1 to EXT4
  * @param[in]   METRO_internal_Channel_t (Channel ID), Channel 1 or 2 ( according to device )
  * @param[in]   u16 in_Metro_Phase_C_calibrator_value
  * @param[out]  None
  * @retval      None
  */
void Metro_HAL_Set_Phase_C_Calibration(METRO_NB_Device_t in_Metro_Device_Id,METRO_internal_Channel_t in_Metro_int_Channel, uint16_t in_Metro_Phase_C_calibrator_value)
{
   uint32_t tmp_addr =0;
  if(in_Metro_Device_Id >= EXT1) 
  {   
     if ( in_Metro_int_Channel == INT_CHANNEL_1)
     {
        /* Reset  Phase C Calibration value bits */
        (p_Metro_Device_Config[in_Metro_Device_Id].metro_stpm_reg.DSPCTRL4) &= ~ BIT_MASK_STPM_PHASE_SHIFT_C1; 
        
        /* Set new Phase C Calibration value to RAM struct for EXT chip */
        (p_Metro_Device_Config[in_Metro_Device_Id].metro_stpm_reg.DSPCTRL4) |= (((uint32_t)(in_Metro_Phase_C_calibrator_value)<<BIT_MASK_STPM_PHASE_SHIFT_C1_SHIFT)& BIT_MASK_STPM_PHASE_SHIFT_C1);
     }
     else  if( in_Metro_int_Channel == INT_CHANNEL_2)
     {
        /* Reset Phase C Calibration value bits */
        (p_Metro_Device_Config[in_Metro_Device_Id].metro_stpm_reg.DSPCTRL4) &= ~ BIT_MASK_STPM_PHASE_SHIFT_C2; 
        
        /* Set new Phase C Calibration value to RAM struct for EXT chip */
        (p_Metro_Device_Config[in_Metro_Device_Id].metro_stpm_reg.DSPCTRL4) |= ((uint32_t)(in_Metro_Phase_C_calibrator_value)& BIT_MASK_STPM_PHASE_SHIFT_C2);
     }

     /* Now send data to the external chip */
     /* Calculate the base address to read inisde STPM chip  */
     /* the offset should be provided in 2 bytes format (16 bits by 16 bits) for STPM */
     tmp_addr = (uint32_t)((uint8_t*)&p_Metro_Device_Config[in_Metro_Device_Id].metro_stpm_reg.DSPCTRL4 - (uint8_t*)&p_Metro_Device_Config[in_Metro_Device_Id].metro_stpm_reg.DSPCTRL1)/2;
       
     /* Now Write the 1 U32 register inside external chip  for DSPCR4  */
     Metro_HAL_Stpm_write(in_Metro_Device_Id,(uint8_t*)&tmp_addr,1,&p_Metro_Device_Config[in_Metro_Device_Id].metro_stpm_reg.DSPCTRL4,STPM_WAIT);
  }
}
/**
  * @brief        Get_Phase C Calibration for Channel requested
  * @param[in]   in_Metro_Device_Id (device ID), HOST or EXT1 to EXT4
  * @param[in]   METRO_internal_Channel_t (Channel ID), Channel 1 or 2 ( according to device )
  * @param[out]  None
  * @retval     Return in_Metro_Phase_C_calibrator_value
  */
uint16_t Metro_HAL_Get_Phase_C_Calibration(METRO_NB_Device_t in_Metro_Device_Id,METRO_internal_Channel_t in_Metro_int_Channel)
{
  uint16_t Phase_C_calibrator_value =0;
    
  if(in_Metro_Device_Id >= EXT1) 
  {
    if ( in_Metro_int_Channel == INT_CHANNEL_1)
    {     
       /* Get Phase C Calibration value from RAM struct for EXT chip */
       Phase_C_calibrator_value = ((p_Metro_Device_Config[in_Metro_Device_Id].metro_stpm_reg.DSPCTRL4) & BIT_MASK_STPM_PHASE_SHIFT_C1)>>BIT_MASK_STPM_PHASE_SHIFT_C1_SHIFT;
    }
    else  if( in_Metro_int_Channel == INT_CHANNEL_2)
    {      
       /* Get Phase C Calibration value from RAM struct for EXT chip */
       Phase_C_calibrator_value = ((p_Metro_Device_Config[in_Metro_Device_Id].metro_stpm_reg.DSPCTRL4) & BIT_MASK_STPM_PHASE_SHIFT_C2);
    }
  }
  return Phase_C_calibrator_value;
}

/**
  * @brief      This function read the Power of signal come from one Channel mapped in one device
* @param[in]   in_Metro_Device_Id : EXT1 to EXT4
  * @param[in]   in_Metro_int_Channel (Channel ID), Channel 1 or 2 ( according to device )
  * @param[in]   in_Metro_Power_Selection : W_ACTIVE , F_ACTIVE, REACTIVE, APPARENT_RMS, APPARENT_VEC, MOM_WIDE_ACT, MOM_FUND_ACT
  * @param[out]  None
  * @retval     int32_t raw_power according to power type  read inside device register
  */

int32_t Metro_HAL_read_power(METRO_NB_Device_t in_Metro_Device_Id,METRO_internal_Channel_t in_Metro_int_Channel,METRO_Power_selection_t in_Metro_Power_Selection)
{
  int32_t raw_power = 0;

  if(in_Metro_Device_Id >= EXT1) 
  {
    switch (in_Metro_Power_Selection)
    {
      case (W_ACTIVE):
      {
        if (in_Metro_int_Channel == INT_CHANNEL_1)
        {
          /* get directly from RAM, be carrefull : latch should be made before to have coherents values inside DSP data reg */
          raw_power = ((p_Metro_Device_Config[in_Metro_Device_Id].metro_stpm_reg.CH1_REG5)&BIT_MASK_STPM_PRIM_CURR_ACTIVE_POW);
        }
        else if (in_Metro_int_Channel == INT_CHANNEL_2)/* is channel 2 */
        {
          /* get directly from RAM, be carrefull !!!!! : latch should be made before to have coherents values inside DSP data reg */
          raw_power = ((p_Metro_Device_Config[in_Metro_Device_Id].metro_stpm_reg.CH2_REG5)&BIT_MASK_STPM_SEC_CURR_ACTIVE_POW);
        }
      }
      break;
      case (F_ACTIVE):
      {
        if (in_Metro_int_Channel == INT_CHANNEL_1)
        {
          /* get directly from RAM, be carrefull : latch should be made before to have coherents values inside DSP data reg */
          raw_power = ((p_Metro_Device_Config[in_Metro_Device_Id].metro_stpm_reg.CH1_REG6)&BIT_MASK_STPM_PRIM_CURR_FUND_POW);
        }
        else if (in_Metro_int_Channel == INT_CHANNEL_2)/* is channel 2 */
        {
          /* get directly from RAM, be carrefull !!!!! : latch should be made before to have coherents values inside DSP data reg */
          raw_power = ((p_Metro_Device_Config[in_Metro_Device_Id].metro_stpm_reg.CH2_REG6)&BIT_MASK_STPM_SEC_CURR_FUND_POW);
        }
      }
      break;
      case (REACTIVE):
      {
        /* is Channel is the first or the second  channel of the chip */
        if (in_Metro_int_Channel == INT_CHANNEL_1)
        {
          /* get directly from RAM, be carrefull : latch should be made before to have coherents values inside DSP data reg */
          raw_power = ((p_Metro_Device_Config[in_Metro_Device_Id].metro_stpm_reg.CH1_REG7)&BIT_MASK_STPM_PRIM_CURR_REACT_POW);
        }
        else if (in_Metro_int_Channel == INT_CHANNEL_2)/* is channel 2 */
        {
          /* get directly from RAM, be carrefull !!!!! : latch should be made before to have coherents values inside DSP data reg */
          raw_power = ((p_Metro_Device_Config[in_Metro_Device_Id].metro_stpm_reg.CH2_REG7)&BIT_MASK_STPM_SEC_CURR_REACT_POW);
         }
      }
      break;
      case (APPARENT_RMS):
      {
        if (in_Metro_int_Channel == INT_CHANNEL_1)
        {
          /* get directly from RAM, be carrefull : latch should be made before to have coherents values inside DSP data reg */
          raw_power = ((p_Metro_Device_Config[in_Metro_Device_Id].metro_stpm_reg.CH1_REG8)&BIT_MASK_STPM_PRIM_CURR_RMS_POW);
        }
        else if (in_Metro_int_Channel == INT_CHANNEL_2)/* is channel 2 */
        {
          /* get directly from RAM, be carrefull !!!!! : latch should be made before to have coherents values inside DSP data reg */
          raw_power = ((p_Metro_Device_Config[in_Metro_Device_Id].metro_stpm_reg.CH2_REG8)&BIT_MASK_STPM_SEC_CURR_RMS_POW);
        }
      }
      break;
      case (APPARENT_VEC):
      {
        if (in_Metro_int_Channel == INT_CHANNEL_1)
        {
          /* get directly from RAM, be carrefull : latch should be made before to have coherents values inside DSP data reg */
          raw_power = ((p_Metro_Device_Config[in_Metro_Device_Id].metro_stpm_reg.CH1_REG9)&BIT_MASK_STPM_PRIM_CURR_VEC_POW);
        }
        else if (in_Metro_int_Channel == INT_CHANNEL_2)/* is channel 2 */
        {
          /* get directly from RAM, be carrefull !!!!! : latch should be made before to have coherents values inside DSP data reg */
          raw_power = ((p_Metro_Device_Config[in_Metro_Device_Id].metro_stpm_reg.CH2_REG9)&BIT_MASK_STPM_SEC_CURR_VEC_POW);
        }
      }
      break;
      case (MOM_WIDE_ACT):
      {
        if (in_Metro_int_Channel == INT_CHANNEL_1)
        {
          /* get directly from RAM, be carrefull : latch should be made before to have coherents values inside DSP data reg */
          raw_power = ((p_Metro_Device_Config[in_Metro_Device_Id].metro_stpm_reg.CH1_REG10)&BIT_MASK_STPM_PRIM_CURR_MOM_ACTIVE_POW);
        }
        else if (in_Metro_int_Channel == INT_CHANNEL_2)/* is channel 2 */
        {
          /* get directly from RAM, be carrefull !!!!! : latch should be made before to have coherents values inside DSP data reg */
          raw_power = ((p_Metro_Device_Config[in_Metro_Device_Id].metro_stpm_reg.CH2_REG10)&BIT_MASK_STPM_SEC_CURR_MOM_ACTIVE_POW);
        }
      }
      break;
      case (MOM_FUND_ACT):
      {
        if (in_Metro_int_Channel == INT_CHANNEL_1)
        {
          /* get directly from RAM, be carrefull : latch should be made before to have coherents values inside DSP data reg */
          raw_power = ((p_Metro_Device_Config[in_Metro_Device_Id].metro_stpm_reg.CH1_REG11)&BIT_MASK_STPM_PRIM_CURR_MOM_FUND_POW);
        }
        else if (in_Metro_int_Channel == INT_CHANNEL_2)/* is channel 2 */
        {
           /* get directly from RAM, be carrefull !!!!! : latch should be made before to have coherents values inside DSP data reg */
          raw_power = ((p_Metro_Device_Config[in_Metro_Device_Id].metro_stpm_reg.CH2_REG11)&BIT_MASK_STPM_SEC_CURR_MOM_FUND_POW);
        }
      }
      break;
    } /* end switch */

    raw_power <<= 4;  // handle sign extension as power is on 28 bits
    raw_power >>= 4;
  }
  return raw_power;
}

/**
  * @brief      This function read the Energy of signal come from one Channel mapped in one device
  * @param[in]   in_Metro_Device_Id (device ID), HOST or EXT1 to EXT4
  * @param[in]   in_Metro_int_Channel (Channel ID), Channel 1 or 2 ( according to device )
  * @param[in]   in_Metro_Energy_Selection : E_W_ACTIVE , E_F_ACTIVE, E_REACTIVE, E_APPARENT
  * @param[out]  None
  * @retval     int32_t raw_nrj according to Energy type  read inside device register
  */

int64_t Metro_HAL_read_energy(METRO_NB_Device_t in_Metro_Device_Id,METRO_internal_Channel_t in_Metro_int_Channel,METRO_Energy_selection_t in_Metro_Energy_Selection)
{
  int32_t raw_nrj = 0;

  if(in_Metro_Device_Id >= EXT1) 
  {
    switch (in_Metro_Energy_Selection)
    {
      case (E_W_ACTIVE):
      {
      if (in_Metro_int_Channel == INT_CHANNEL_1)
        {
         /* get directly from RAM, be carrefull : latch should be made before to have coherents values inside DSP data reg */
          raw_nrj = ((p_Metro_Device_Config[in_Metro_Device_Id].metro_stpm_reg.CH1_REG1));
        }
        else if (in_Metro_int_Channel == INT_CHANNEL_2)
        {
          /* get directly from RAM, be carrefull !!!!! : latch should be made before to have coherents values inside DSP data reg */
          raw_nrj = ((p_Metro_Device_Config[in_Metro_Device_Id].metro_stpm_reg.CH2_REG1));
        }
      }
      break;
      case (E_F_ACTIVE):
      {
        if (in_Metro_int_Channel == INT_CHANNEL_1)
        {
          /* get directly from RAM, be carrefull : latch should be made before to have coherents values inside DSP data reg */
          raw_nrj = ((p_Metro_Device_Config[in_Metro_Device_Id].metro_stpm_reg.CH1_REG2));
        }
        else if (in_Metro_int_Channel == INT_CHANNEL_2)/* is channel 2 */
        {
          /* get directly from RAM, be carrefull !!!!! : latch should be made before to have coherents values inside DSP data reg */
          raw_nrj = ((p_Metro_Device_Config[in_Metro_Device_Id].metro_stpm_reg.CH2_REG2));
        }
      }
      break;
      case (E_REACTIVE):
      {
        if (in_Metro_int_Channel == INT_CHANNEL_1)
        {
          /* get directly from RAM, be carrefull : latch should be made before to have coherents values inside DSP data reg */
          raw_nrj = -((p_Metro_Device_Config[in_Metro_Device_Id].metro_stpm_reg.CH1_REG3));
        }
        else if (in_Metro_int_Channel == INT_CHANNEL_2)/* is channel 2 */
        {
          /* get directly from RAM, be carrefull !!!!! : latch should be made before to have coherents values inside DSP data reg */
          raw_nrj = -((p_Metro_Device_Config[in_Metro_Device_Id].metro_stpm_reg.CH2_REG3));
        }
      }
      break;
      case (E_APPARENT):
      {
      if (in_Metro_int_Channel == INT_CHANNEL_1)
        {
          /* get directly from RAM, be carrefull : latch should be made before to have coherents values inside DSP data reg */
          raw_nrj = ((p_Metro_Device_Config[in_Metro_Device_Id].metro_stpm_reg.CH1_REG4));
        }
        else if (in_Metro_int_Channel == INT_CHANNEL_2)/* is channel 2 */
        {
          /* get directly from RAM, be carrefull !!!!! : latch should be made before to have coherents values inside DSP data reg */
          raw_nrj = ((p_Metro_Device_Config[in_Metro_Device_Id].metro_stpm_reg.CH2_REG4));
        }
      }
      break;
    } /* end switch */
  }
  return raw_nrj;
}

/**
  * @brief       Set IRQ Mask for a channel
  * @param[in]   in_Metro_Device_Id (device ID), HOST or EXT1 to EXT4
  * @param[in]   in_Metro_int_Channel (Channel ID), Channel 1 or 2 ( according to device )
  * @param[in]   in_Metro_IT_Mask :  Mask of interruption according to the channel
  * @param[out]  None
  * @retval      None
  */
void Metro_HAL_Set_IRQ_Mask_for_Channel(METRO_NB_Device_t in_Metro_Device_Id,METRO_internal_Channel_t in_Metro_int_Channel,uint32_t in_Metro_IT_Mask)
{
  uint32_t tmp_addr =0; 
   
  if(in_Metro_Device_Id >= EXT1) 
  {
    if ( in_Metro_int_Channel == INT_CHANNEL_1)
    {      
       /* Set new IRQ Mask for IRQ1 to RAM struct for EXT chip */
       (p_Metro_Device_Config[in_Metro_Device_Id].metro_stpm_reg.DSPIRQ1) = in_Metro_IT_Mask&BIT_MASK_STPM_CHANNEL1_IRQ1;
    }
    else  if( in_Metro_int_Channel == INT_CHANNEL_2)
    {      
       /* Set new IRQ Mask for IRQ2 to RAM struct for EXT chip */
       (p_Metro_Device_Config[in_Metro_Device_Id].metro_stpm_reg.DSPIRQ2) = in_Metro_IT_Mask&BIT_MASK_STPM_CHANNEL2_IRQ2;
    }

    /* Now send data to the external chip */
    /* Calculate the base address to read inisde STPM chip  */
    /* the offset should be provided in 2 bytes format (16 bits by 16 bits) for STPM */
    tmp_addr = (uint32_t)((uint8_t*)&p_Metro_Device_Config[in_Metro_Device_Id].metro_stpm_reg.DSPIRQ1 - (uint8_t*)&p_Metro_Device_Config[in_Metro_Device_Id].metro_stpm_reg.DSPCTRL1)/2;
       
    /* Now Write the 2 U32 register inside external chip  for DSPIRQ1 and DSPIRQ2  */
    Metro_HAL_Stpm_write(in_Metro_Device_Id,(uint8_t*)&tmp_addr,2,&p_Metro_Device_Config[in_Metro_Device_Id].metro_stpm_reg.DSPIRQ1,STPM_WAIT);
  }
}

/**
  * @brief      Get IRQ Mask for a channel
  * @param[in]   in_Metro_Device_Id (device ID), HOST or EXT1 to EXT4
  * @param[in]   in_Metro_int_Channel (Channel ID), Channel 1 or 2 ( according to device )
  * @param[out]  None
  * @retval     u32 Metro_IT_Mask
  */
uint32_t Metro_HAL_Get_IRQ_Mask_for_Channel(METRO_NB_Device_t in_Metro_Device_Id,METRO_internal_Channel_t in_Metro_int_Channel)
{
  uint32_t Metro_IT_Mask =0;
    
  if(in_Metro_Device_Id >= EXT1) 
  {
    if ( in_Metro_int_Channel == INT_CHANNEL_1)
    {      
       /* Get IRQ Mask for IRQ1 from RAM struct for EXT chip */
       Metro_IT_Mask=(p_Metro_Device_Config[in_Metro_Device_Id].metro_stpm_reg.DSPIRQ1);
    }
    else  if( in_Metro_int_Channel == INT_CHANNEL_2)
    {      
       /* Get IRQ Mask for IRQ2 from RAM struct for EXT chip */
       Metro_IT_Mask=(p_Metro_Device_Config[in_Metro_Device_Id].metro_stpm_reg.DSPIRQ2);
    }
  }
  return Metro_IT_Mask;
}

/**
  * @brief       Get the specified live event for a channel
  * @param[in]   in_Metro_Device_Id (device ID), HOST or EXT1 to EXT4
  * @param[in]   in_Metro_int_Channel (Channel ID), Channel 1 or 2 ( according to device )
  * @param[in]   METRO_Live_Event_Type_t type ( Live events are generated by DSP)
  * @param[out]  None
  * @retval     u32 : return full Live event Register  if in_Metro_Live_Event_requested == ALL_LIVE_EVENTS
  *             otherwise :the  Live event requested
  */
uint32_t Metro_HAL_Read_Live_Event_from_Channel(METRO_NB_Device_t in_Metro_Device_Id,METRO_internal_Channel_t in_Metro_int_Channel, METRO_Live_Event_Type_t in_Metro_Live_Event_requested)
{
  uint32_t Metro_Live_Event_reg =0;
   
  if(in_Metro_Device_Id >= EXT1) 
  {
    switch (in_Metro_Live_Event_requested)
    {
      /* All events requested, send back the full u32 reg */
      case ALL_LIVE_EVENTS:
      {
         if ( in_Metro_int_Channel == INT_CHANNEL_1)
         {      
            /* Get Live Event Mask  from RAM struct for EXT chip */
            Metro_Live_Event_reg=(p_Metro_Device_Config[in_Metro_Device_Id].metro_stpm_reg.DSPEVENT1);
         }
         else  if( in_Metro_int_Channel == INT_CHANNEL_2)
         {      
            /* Get Live Event Mask from RAM struct for EXT chip */
            Metro_Live_Event_reg=(p_Metro_Device_Config[in_Metro_Device_Id].metro_stpm_reg.DSPEVENT2);
         }
       }
       break;
       /* now the other cases , are bit by bit inside DSPEVEnts register */
       case LIVE_EVENT_VOLTAGE_SAG:
       {
         if ( in_Metro_int_Channel == INT_CHANNEL_1)
         {      
            /* Get Live Event Mask  from RAM struct for EXT chip */
            Metro_Live_Event_reg=((p_Metro_Device_Config[in_Metro_Device_Id].metro_stpm_reg.DSPEVENT1)&BIT_MASK_STPM_VOLT_SAG_EV)>>BIT_MASK_STPM_VOLT_SAG_EV_SHIFT;
         }
         else  if( in_Metro_int_Channel == INT_CHANNEL_2)
         {      
            /* Get Live Event Mask from RAM struct for EXT chip */
            Metro_Live_Event_reg=((p_Metro_Device_Config[in_Metro_Device_Id].metro_stpm_reg.DSPEVENT2)&BIT_MASK_STPM_VOLT_SAG_EV)>>BIT_MASK_STPM_VOLT_SAG_EV_SHIFT;
         }
       }
       break;
       case LIVE_EVENT_VOLTAGE_SWELL:
       {
         if ( in_Metro_int_Channel == INT_CHANNEL_1)
         {      
            /* Get Live Event Mask  from RAM struct for EXT chip */
            Metro_Live_Event_reg=((p_Metro_Device_Config[in_Metro_Device_Id].metro_stpm_reg.DSPEVENT1)&BIT_MASK_STPM_VOLT_SWELL_EV)>>BIT_MASK_STPM_VOLT_SWELL_EV_SHIFT;
         }
         else  if( in_Metro_int_Channel == INT_CHANNEL_2)
         {      
            /* Get Live Event Mask from RAM struct for EXT chip */
            Metro_Live_Event_reg=((p_Metro_Device_Config[in_Metro_Device_Id].metro_stpm_reg.DSPEVENT2)&BIT_MASK_STPM_VOLT_SWELL_EV)>>BIT_MASK_STPM_VOLT_SWELL_EV_SHIFT;
         }
       }
       break;
       case LIVE_EVENT_VOLTAGE_PERIOD_STATUS:
       {
         if ( in_Metro_int_Channel == INT_CHANNEL_1)
         {      
            /* Get Live Event Mask  from RAM struct for EXT chip */
            Metro_Live_Event_reg=((p_Metro_Device_Config[in_Metro_Device_Id].metro_stpm_reg.DSPEVENT1)&BIT_MASK_STPM_VOLT_PERIOD_STATUS_EV)>>BIT_MASK_STPM_VOLT_PERIOD_STATUS_EV_SHIFT;
         }
         else  if( in_Metro_int_Channel == INT_CHANNEL_2)
         {      
            /* Get Live Event Mask from RAM struct for EXT chip */
            Metro_Live_Event_reg=((p_Metro_Device_Config[in_Metro_Device_Id].metro_stpm_reg.DSPEVENT2)&BIT_MASK_STPM_VOLT_PERIOD_STATUS_EV)>>BIT_MASK_STPM_VOLT_PERIOD_STATUS_EV_SHIFT;
         }
       }
       break;
       case LIVE_EVENT_VOLTAGE_SIGNAL_STUCK:
       {
         if ( in_Metro_int_Channel == INT_CHANNEL_1)
         {      
            /* Get Live Event Mask  from RAM struct for EXT chip */
            Metro_Live_Event_reg=((p_Metro_Device_Config[in_Metro_Device_Id].metro_stpm_reg.DSPEVENT1)&BIT_MASK_STPM_VOLT_SIG_STUCK_EV)>>BIT_MASK_STPM_VOLT_SIG_STUCK_EV_SHIFT;
         }
         else  if( in_Metro_int_Channel == INT_CHANNEL_2)
         {      
            /* Get Live Event Mask from RAM struct for EXT chip */
            Metro_Live_Event_reg=((p_Metro_Device_Config[in_Metro_Device_Id].metro_stpm_reg.DSPEVENT2)&BIT_MASK_STPM_VOLT_SIG_STUCK_EV)>>BIT_MASK_STPM_VOLT_SIG_STUCK_EV_SHIFT;
         }
       }
       break;
       case LIVE_EVENT_VOLTAGE_ZCR:
       {
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
         }
       }
       break;
       case LIVE_EVENT_CURRENT_SIGN_CHANGE_FUNDAMENTAL_POWER:
       {
         if ( in_Metro_int_Channel == INT_CHANNEL_1)
         {      
            /* Get Live Event Mask  from RAM struct for EXT chip */
            Metro_Live_Event_reg=((p_Metro_Device_Config[in_Metro_Device_Id].metro_stpm_reg.DSPEVENT1)&BIT_MASK_STPM_CH_PS_F_EV)>>BIT_MASK_STPM_CH_PS_F_EV_SHIFT;
         }
         else  if( in_Metro_int_Channel == INT_CHANNEL_2)
         {      
            /* Get Live Event Mask from RAM struct for EXT chip */
            Metro_Live_Event_reg=((p_Metro_Device_Config[in_Metro_Device_Id].metro_stpm_reg.DSPEVENT2)&BIT_MASK_STPM_CH_PS_F_EV)>>BIT_MASK_STPM_CH_PS_F_EV_SHIFT;
         }
       }
       break;
       case LIVE_EVENT_CURRENT_SIGN_CHANGE_ACTIVE_POWER:
       {
         if ( in_Metro_int_Channel == INT_CHANNEL_1)
         {      
            /* Get Live Event Mask  from RAM struct for EXT chip */
            Metro_Live_Event_reg=((p_Metro_Device_Config[in_Metro_Device_Id].metro_stpm_reg.DSPEVENT1)&BIT_MASK_STPM_CH_PS_A_EV)>>BIT_MASK_STPM_CH_PS_A_EV_SHIFT;
         }
         else  if( in_Metro_int_Channel == INT_CHANNEL_2)
         {      
            /* Get Live Event Mask from RAM struct for EXT chip */
            Metro_Live_Event_reg=((p_Metro_Device_Config[in_Metro_Device_Id].metro_stpm_reg.DSPEVENT2)&BIT_MASK_STPM_CH_PS_A_EV)>>BIT_MASK_STPM_CH_PS_A_EV_SHIFT;
         }
       }
       break;
       case LIVE_EVENT_CURRENT_NAH:
       {
         if ( in_Metro_int_Channel == INT_CHANNEL_1)
         {      
            /* Get Live Event Mask  from RAM struct for EXT chip */
            Metro_Live_Event_reg=((p_Metro_Device_Config[in_Metro_Device_Id].metro_stpm_reg.DSPEVENT1)&BIT_MASK_STPM_CURR_AH_ACC_EV)>>BIT_MASK_STPM_CURR_AH_ACC_EV_SHIFT;
         }
         else  if( in_Metro_int_Channel == INT_CHANNEL_2)
         {      
            /* Get Live Event Mask from RAM struct for EXT chip */
            Metro_Live_Event_reg=((p_Metro_Device_Config[in_Metro_Device_Id].metro_stpm_reg.DSPEVENT2)&BIT_MASK_STPM_CURR_AH_ACC_EV)>>BIT_MASK_STPM_CURR_AH_ACC_EV_SHIFT;
         }
       }
       break;
    }
  }
  return Metro_Live_Event_reg; 
}
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
